tiimsvk/WeatherStation-V-3.0-Esphome/(list of files, cad)

Other CAD files:
weather-station-wiring.dwg
