tiimsvk/WeatherStation-V-3.0-Esphome/(threads)

Thread 2 (2024-10-11):

But where is firmware?

zakdma, 2024-10-11:
I see only a list of the sensors.
But there is no any firmware or construction drawings.

Pank172, 2024-11-08:
Dear, what program did you use to create the weather station electrical diagram file?

Pank172, 2024-11-09:
Dear, I can't compile the file. ESPHome gives me an error log.
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
[logs_weather-station_compile (1).txt](https://github.com/user-attachments/files/17686985/logs_weather-station_compile.1.txt)

tiimsvk, 2024-11-09:
> Dear, what program did you use to create the weather station electrical diagram file?

Autocad

Pank172, 2024-11-09:
I am copying your project to ESPHome, but I cannot compile the firmware. The compilation fails with an error.

tiimsvk, 2024-11-09:
> Dear, I can't compile the file. ESPHome gives me an error log. [logs_weather-station_compile (1).txt](https://github.com/user-attachments/files/17686985/logs_weather-station_compile.1.txt)

oh yes you are right.  When I'm behind the PC, I'll upload the custom components

Pank172, 2024-11-11:
Hello. I still can't compile your yaml file. Can you share your new file?

tiimsvk, 2024-11-12:
I uploaded the file custom_component.zip. It needs to be unpacked into the esphome/custom_component folder.

Pank172, 2024-11-17:
Dear, I apologize. Did you use PlatformIO to compile? Which compiler? I haven't used PlatformIO before.

tiimsvk, 2024-11-18:
I don't understand the question? I compile the code directly in home assistant via esphome with the latest current version and the output is without problems.

Pank172, 2024-11-18:
Do you mount additional libraries directly into ESPHome? I don't know how to do that yet.

Allkorolev, 2024-11-20:
Files in the custom_component archive.zip is broken, please re-upload the archive.

tiimsvk, 2024-11-22:
> Files in the custom_component archive.zip is broken, please re-upload the archive.

I tested the uploaded file. It downloaded and unzipped without any problems.

Allkorolev, 2024-11-24:
> > Files in the custom_component archive.zip is broken, please re-upload the archive.
>
> I tested the uploaded file. It downloaded and unzipped without any problems.

Problem detected with files in the Dallas folder

tiimsvk, 2024-11-26:
I think esphome has already fixed the error in dallas. Try deleting the folder.

Pank172, 2025-04-10:
Sorry. And you don't have a regular circuit. It takes a long time to reverse engineer. It will take some time. I want to model your board in DIP TRACE and then make a printed circuit board.

Pank172, 2025-04-10:
Unfortunately, I don't speak English, my native language is Ukrainian. Therefore, I am forced to use Google Translate.

tiimsvk, 2025-04-11:
> Sorry. And you don't have a regular circuit. It takes a long time to reverse engineer. It will take some time. I want to model your board in DIP TRACE and then make a printed circuit board.

If I make a circuit, for example in EasyEDA, it will probably be only when I’m repairing something on the weather station. Right now, I wouldn’t have time for that. But a PCB board would definitely be great.

Pank172, 2025-04-11:
Good afternoon. I am currently recovering from knee surgery. So I have some free time. I will start designing the PCB. This is not a very fast process. Now I have AutoCAD, PDF and YAML files. I will debug the board in Proteus. This will take some time.
If you have time to make a drawing of the board, it will help in the work. Some clarification is still needed regarding the modules.

Pank172, 2025-04-11:
Could you clarify the information regarding discrete modules? Namely their quantity, because they are not indicated in the description.
This concerns the modules: INA3221, LDO DD2712SA/5V? These modules are drawn several times in your diagram. Therefore, a question arises. As I understood from the diagram, ceramic capacitors are installed to reduce power surges. I also saw several electrolytic capacitors on the diagram.

Pank172, 2025-04-30:
Hello. Finally, I have some free time and I have finished drawing the circuit diagram and prototype of the printed circuit board of your weather station in the DIP TRACE program. I am leaving the files of my work.

[MeteoStation V.3 ESP32_gerber.zip](https://github.com/user-attachments/files/19980454/MeteoStation.V.3.ESP32_gerber.zip)

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

Pank172, 2025-04-30:
DIP TRACE format files

[Метеостанція ESP32.zip](https://github.com/user-attachments/files/19980530/ESP32.zip)

Pank172, 2025-08-05:
Good afternoon. After the latest ESPHome updates, the project cannot be compiled. How did you deal with this? Can you post the updated project data?

tiimsvk, 2025-08-06:
LOG?

tiimsvk, 2025-08-12:
I uploaded a new FW, but be careful, it's a test version because I'm modifying the UV sensor and the pins on the geiger have changed. I'll update next month.
