tiimsvk/WeatherStation-V-3.0-Esphome/wiring weather station.pdf

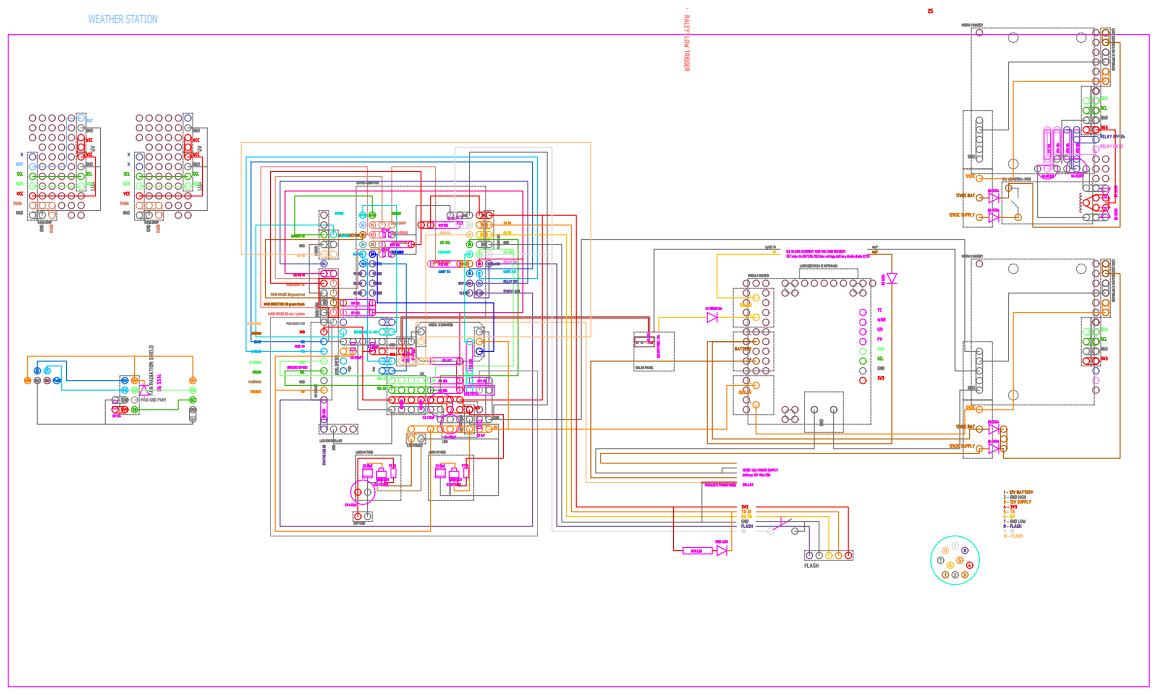
[picture p2: page 1]
WEATHER STATION
