tiimsvk/WeatherStation-V-3.0-Esphome/weather-station.yaml

#-------------------------------------------
# BUG AND REPAIR
#-------------------------------------------
# FIX dependency detceted odstranit z polozky kjtora odkazuje sama na seba (napr vltage bus presunut on value na power)
 # if switch off reducer_consumption_pin bad values adc pins is high (control out voltage when no measure)
# Fix drop 12.5 Voltage charge
# no measure rain when is shutdown change GPIO5 to GPIO12 (GPIO05 strapping pin high at boot)
# "task_wdt: Task watchdog got triggered. The following tasks did not reset the watchdog in time:" FIX: more sensors ... change id name length to short.
# add voltage detektor reset mcu supervisor smd
# aneometer WH-SP-WS01 bad value fixed 2x
# add weather condition whit pressure

#-------------------------------------------
# REVISION
#-------------------------------------------
# 2023.09.3.2.0
 # - replace PM1006 by SPS30
 # - replace MQ2 by MQ9
 # - add step up module DIO6605B
 # - remove spotlight
 # - modification state led

# 2023.10.3.2.1
 # - fix sps30 count/m3

# 2023.11.3.3.0
 # replace BH-1750 lux and UV GYML8511 to LTR-390UV

# 2023.12.3.4
 # add SHT45 prevent bad humidity value
 # remove laching relay and add step down power supply 8V
 # replace new raindrop sensor
 # calibrate pressure +12
 # Wind add cradient https://sk.wikipedia.org/wiki/Beaufortova_stupnica_sily_vetra 
 # Wind speed add max speed per online https://community.home-assistant.io/t/measuring-wind-speed/395693/7
 # wind speed change gpio26 
 # wind heading full round

# 2024.04.3.3.5
 # replace broken dallas sensor on solar panel
 # replace broken dallas sensor battery
 # add 104 capacitor rain gaige and wind speed sensor source: https://www.instructables.com/Solar-Powered-WiFi-Weather-Station-V30/
 # rain gauge change to pullup snesors and fix code whit wakeup reason and sleep
 # remove multiplier uv sesnor filter
 # fixed pm calculate

# 2024.04.3.3.6
 # fixed wind heading mounted to solar panels

# 2024.05.3.3.7
 # Add total rain sensor fixed daily rain.

# 2024.07.3.3.8
 # - change gain X3 to X6 UV LTR390 sensor
 # - fixed bad value dallas battery sensor filter out 85°C broken after esphome update 2024.6

# 2024.07.19.3.3.9
 # bad value aneomter WH-SP-WS01 reference shmu multiple 2x added
 
# 2025.08.12.3.4.0
 # Add UV ADC sensor - GYML8511 replace shield glass to UV Fused Quartz Glass Clear Transparent 
 # Fixed Geiger counter change GPIO04
 # update FW and last esphome
 
#-------------------------------------------
# SUBTITUTIONS - basic definitions and description of the device
#-------------------------------------------
substitutions:
  device_name: ESP-Weatherstation
  friendly_name: weather-station
  created_by: StudioTiiM 2021-2024
  device_description: "A complete battery-powered weather monitoring station"

#-------------------------------------------
# CONECTION OF CABLES
#-------------------------------------------
# RADIATION SHIELD:
  # USB cable:
    # white  : NO 
    # green  : Smoke ADC
    # blue   : GND
    # orange : 5V
  # LAN cable:
    # dark brown  : 5V
    # brig brown  : GND PWM
    # dark blue   : SPS30 SCL
    # brig blue   : SPS30 SDA
    # dark orange : 3.3V
    # brig orange : GND
    # dark green  : MHZ RX
    # brig green  : MHZ TX
    
# SOLAR SHIELD
 # LAN cable:
    # dark brown  : 3V3
    # brig brown  : GND
    # dark blue   : UV ADC
    # brig blue   : not connect
    # dark orange : SCL
    # brig orange : SDA
    # dark green  : not connect
    # brig green  : RAIN ADC

#-------------------------------------------
# POWER CONSUMPTION 
# whit multimeter
#-------------------------------------------
# Power consumption 12V
# First booting MCU + MCU CAM: 300mA
# Booting MCU: 180mA
# Heating sensors: 130mA
# Normal: 40mA
# Deep sleep: 17mA

# Power consumption 5V
# First booting MCU + MCU CAM: 510mA
# Booting MCU after connected to mqtt: 350mA
# Heating sensors: 330mA
# Normal: 270mA
# Deep sleep: 13mA

#-------------------------------------------
# DEFINE PINS AND VARIABILES
# CIRCUIT AND MODULES - basic definitions and description of the device
#-------------------------------------------

# ----- MCU -----
  # Module: ESP32-S + adapter
   # Circuit: Solder on Prototype PCB expansion board ESP32 7x9cm

   # Power Consumption: Peak ~  / Normal wifi:  ~  / Normal: ~  / DeepSleep: ~ 
   # Specification: Chip Family: ESP32 / Chip Model: ESP32S / Chip ID:  / MAC Address:  / Number of Cores:  / CPU Frequency: 240MHz / Ram:  / Flash: 

   # Description pins:
    # PINS ESP32    | FUNCTION     | INPUT | OUTPUT | ADC | PWM | I2C           | SPI  | RESISTOR             | BOOT       | FLASH   | HIGH AT BOOT | BOOT FAILS | NOTES
    # ------------------------------------------------------------------------------------------------------------------------------------------------------------------------------
    # EN            | RESET                                                            | 10.0k PULLUP PCB     |                                     |
    # GPIO0         | STRAPPING    | OK!   | OK!    |     | OK  | OK            |      | 10.0k PULLUP         | PULLUP    | PULLDOWN | PWM          | LOW
    # GPIO01 *      | TX           | OK!*1 | OK     |     | OK  | OK            |      |                      |           |          | HIGH         |            | CONNECTED CH340C
    # GPIO02 *      | STATUS LED   | OK    | OK     |     | OK  | OK            |      | INTERNAL PULLDOWN    | PULLUP    |          | HIGH         |            | LED OR PULLUP 10k
    # GPIO03 *      | RX           | OK    | OK!*1  |     | OK  | OK            |      |                      |           |          | HIGH         |            | CONNECTED CH340C
    # GPIO04        |              | OK    | OK     |     | OK  | OK            |      | INTERNAL PULLDOWN    |           |          |              |
    # GPIO05 *      | STRAPPING    | OK    | OK!    |     | OK  | OK            |      | INTERNAL PULLUP      |           |          | PWM          | LOW
    # GPIO06        | INTERNAL SPI |       |        |     |     |               | CLK  |                      |           |          |              |
    # GPIO07        | INTERNAL SPI |       |        |     |     |               | MISO |                      |           |          |              |
    # GPIO08        | INTERNAL SPI |       |        |     |     |               | MOSI |                      |           |          |              |
    # GPIO09        | INTERNAL SPI |       |        |     |     |               | HD   |                      |           |          | HIGH         |
    # GPIO10        | INTERNAL SPI |       |        |     |     |               | WP   |                      |           |          | HIGH         |
    # GPIO11        | SPI CSC/CMD  |       |        |     |     |               | CS   |                      |           |          | HIGH         |
    # GPIO12        | STRAPPING    | OK!*3 | OK     |     | OK  | OK            |      |                      |           |          | LOW          | HIGH
    # GPIO13        |              | OK    | OK     |     | OK  | OK            |      |                      |           |          |              |
    # GPIO14        |              | OK    | OK     |     | OK  | OK            |      |                      |           |          | PWM          |
    # GPIO15        | STRAPPING    | OK!   | OK!    |     | OK  | OK            |      |                      | PULLDOWN  |          | PWM          | HIGH
    # GPIO16 *      | PSRAM*4      | OK    | OK     |     | OK  | OK            |      |                      |           |          | PWM          |
    # GPIO17 *      | PSRAM*4      | OK    | OK     |     | OK  | OK            |      |                      |           |          | PWM          |
    # GPIO18        |              | OK    | OK     |     | OK  | OK            |      |                      |           |          |              |
    # GPIO19 *      |              | OK    | OK     |     | OK  | OK            |      |                      |           |          |              |

    # GPIO21 *      |              | OK    | OK     |     | OK  | OK            |      |                      |           |          |              |
    # GPIO22 *      |              | OK    | OK     |     | OK  | OK            |      |                      |           |          |              |
    # GPIO23 *      |              | OK    | OK     |     | OK  | OK            |      |                      |           |          |              |
    
    # GPIO25 *      |              | OK    | OK     |     | OK  | OK            |      |                      |           |          |              |
    # GPIO26        |              | OK    | OK     |     | OK  | OK            |      |                      |           |          |              |
    # GPIO27 *      |              | OK    | OK     |     | OK  | OK            |      |                      |           |          |              |

    # GPIO32 *      |              | OK    | OK     |     | OK  | OK            |      |                      |           |          |              |
    # GPIO33 *      |              | OK    | OK     |     | OK  | OK            |      |                      |           |          |              |
    
    # GPIO34 *      |              | OK    |        | OK  |     |               |      |                      |           |          |              |
    # GPIO35 *      |              | OK    |        | OK  |     |               |      |                      |           |          |              |
    # GPIO36 *      | VP *6        | OK*5  |        | OK  |     |               |      |                      |           |          |              |
    # GPIO39 *      | VN *6        | OK*5  |        | OK  |     |               |      |                      |           |          |              |

    # * Connected on this project
    # *1 Disable hardware uart. logger baud_rate: 0
    # *2 recommended I2C
    # *3 May damage flash if low at boot on 1.8V flash chips
    # *4 GPIO 16 & 17 are usually connected to the SPI flash and PSRAM. These do show some activity during boot to detect the presence of PSRAM. For example GPIO 17 may still show some high frequency signal until it is specifically set to a high or low output state. When PSRAM is present, these pins should not be used.
    # *5 GPIO 36 & 39 should not be used for interrupts when also using ADC or WiFi and Bluetooth. These pins are on some boards labelled as: 
    #    The internal Hall sensor in the ESP32 is connected to these two pins.
    #    The Hall Sensor uses channels 0 and 3 of ADC1. Do not configure these channels for use as ADC channels when also reading from the Hall sensor.
    # *6 VP-GPIO36 or VN-GPIO39 high impedance pin
    # GPIO08 and GPIO09 pulldown invalid on boot
    # Current draw 12mA max per GPIO
    # * used on project

 # ----- LEDS -----
  # Modul: Status led
   # Specification: 1x red led
   # Circuit: 10Ω resistor to GPIO
   # Power consumption: 15mA
  status_led: GPIO02
  # Modul: Spotlight not connected
   # Specification: 8x high brightness white leds
   # Circuit: 15Ω resistor to 5V / switching whit NPN Darlington TIP122: Gate - 220Ω GPIO / Gate-Source 10kΩ pulldown
   # Power consumption: 200mA (1pic = 3.3V 25mA)
  # spotlight: GPIO26

 # ----- SMOKE SENSOR -----
 # ----- OLD SENSOR -----
  # Module: MQ-2 Smoke and Gas Sensor
   # Specification: Voltage	5V / Load resistance 20kΩ / Heater resistance	33Ω ± 5% / Heating consumption	<800mw / Sensing Resistance	10 KΩ ~ 60 KΩ / Concentration Range	200 ~ 10000ppm / Preheat Time	Over 24 hour
   # Power consumption: preheat 135mA / standby 
   # Settings: time heating and measure min. 100s
   # RL replace resistor 1kΩ to 2kΩ
   # https://circuitdigest.com/microcontroller-projects/arduino-smoke-detector-on-pcb-using-mq2-gas-sensor
   # First stable value after 90s
  #mq2_pin: GPIO39 # SVN
  # Calibrate:
  # Look datasheet and MQ-2 Gas Sensor Sensitivity Characteristics in Graph:
   # https://thestempedia.com/tutorials/interfacing-mq-2-gas-sensor-with-evive/
   # The graph tells us the concentration of a gas in part per million (ppm) according to the resistance ratio of the sensor (RS/R0).
    # RS is the resistance of the sensor that changes depending on the concentration of gas.
    # R0 is the resistance of the sensor at a known concentration without the presence of other gases, or in the fresh air.

    # RS = (Vin - Vout) / Vout
    
   # After 15 min. ready "MQ2 - R0" value and replace ro value
  #r0_value: "1.565"
   
   # Calculating PPM for a particular gas
   # Analyze the graph:

    # - The scale of the graph is log-log. This means that in a linear scale, the behavior of the gas concentration with respect to the resistance ratio is exponential.
    # - The data for gas concentration only ranges from 200 ppm to 10000 ppm.
    # - Even though the relation between resistance ratio and gas concentration may seem linear, in reality, it is not.

   # First of all, we will treat the lines as if they were linear. This way we can use one formula that linearly relates the ratio and the concentration. 
   # By doing so, we can find the concentration of a gas at any ratio value even outside of the graph’s boundaries.
   # The formula we will be using is the equation for a line, but for a log-log scale. The formula for a line is:
   
   # Math:
    # y: Y value              y = mx + b   
    # x: X value              x = 10 ^ {[log(y) - b] / m}
    # m: Slope of the line    m = log(y/y0) / log(x/x0)
    # b: Y intercept          b = log(y) - m*log(x)

    # For a log-log scale, the formula looks like this:  
    #  log(y) = m*log(x) + b  

    # Measure Smoke and CO calculate a defines in the sensor field

 # ----- NEW SENSOR -----
  # Module: MQ-2 Smoke and Gas Sensor
   # Specification: Voltage	5V / Load resistance 20kΩ / Heater resistance	33Ω ± 5% / Heating consumption	<800mw / Sensing Resistance	10 KΩ ~ 60 KΩ / Concentration Range	200 ~ 10000ppm / Preheat Time	Over 24 hour
   # Power consumption: preheat 135mA / standby 
   # Settings: time heating and measure min. 100s
   # https://circuitdigest.com/microcontroller-projects/arduino-smoke-detector-on-pcb-using-mq2-gas-sensor
   # First stable value after 90s
   # circuit output signal when the sensor is shifted from clean air to carbon monoxide (CO) or CH4, output signal 
   # measurement is made within one or two complete heating period (2.5 minute from high voltage (60s - 5V) to low voltage (90s - 1.4V)).

  mqx_pin: GPIO39 # SVN
  # Calibrate:
  # Look datasheet and MQ-9 Gas Sensor Sensitivity Characteristics in Graph:
   # https://thestempedia.com/tutorials/interfacing-mq-2-gas-sensor-with-evive/
   # The graph tells us the concentration of a gas in part per million (ppm) according to the resistance ratio of the sensor (RS/R0).
    # RS is the resistance of the sensor that changes depending on the concentration of gas.
    # R0 is the resistance of the sensor at a known concentration without the presence of other gases, or in the fresh air.

    # RS = (Vin - Vout) / Vout
    
   # After 15 min. ready "MQ2 - R0" value and replace ro value
  r0_value: "2.732"
   
   # Calculating PPM for a particular gas
   # Analyze the graph:

    # - The scale of the graph is log-log. This means that in a linear scale, the behavior of the gas concentration with respect to the resistance ratio is exponential.
    # - The data for gas concentration only ranges from 200 ppm to 10000 ppm.
    # - Even though the relation between resistance ratio and gas concentration may seem linear, in reality, it is not.

   # First of all, we will treat the lines as if they were linear. This way we can use one formula that linearly relates the ratio and the concentration. 
   # By doing so, we can find the concentration of a gas at any ratio value even outside of the graph’s boundaries.
   # The formula we will be using is the equation for a line, but for a log-log scale. The formula for a line is:
   
   # Math:
    # y: Y value              y = mx + b   
    # x: X value              x = 10 ^ {[log(y) - b] / m}
    # m: Slope of the line    m = log(y/y0) / log(x/x0)
    # b: Y intercept          b = log(y) - m*log(x)

    # For a log-log scale, the formula looks like this:  
    #  log(y) = m*log(x) + b  

    # Measure Smoke and CO calculate a defines in the sensor field

 # ----- REDUCER CONSUMPTION -----
  # Module: LaskaKit Bat-Boost 5V 0.6A Chiptron
   # Chip: DIO6605B
   # Specification: Voltage in 2.7 ~ 4.5V out fixed 5V / current max 0.6A / frequency: 1.2MHz / efficiency 95% / stadby current: 1μA, quiescent current: 55 / protection: overtemperature; Working temperature -40 ~ 85 °C / Logic EN pin: 1.8V
 
  # "Settings: time heating and measure min 3min delay measure (10x per day)"
   # delay measure and minimal consumption battery: MQ9 CO sensor
  reducer_pin: GPIO27

 # ----- TEMPERATURE / HUMIDITY / PRESSURE SENSORS -----
  # Module: Dallas DS18B20
   # Circuit: 4.7k resistor data pin to VCC
   # Power consumption: 50μA
   # Measure: Solar panel and Battery
  dallas_pin: GPIO23
   # UPDATE AFTER BOOT: 1s

  # Module: BME280 - pressure / humidity / temperature (ALT. DHT21 AM2301 750μA; BMP280)
   # Specifications: Voltage: 1.8 ~ 5V / Operational Range: Temperature: -40 ~ +85°C Humidity: 0~100% Pressure: 300~1100 hPa / Accuracy: Temperature: +-1°C Humidity: +-3% Pressure: +-1Pa
   # Circuit: Interface: I2C address: SDO LOW : 0x76 (SDO HIGH: 0x77)
   # Power consumption: 0.4mA
   # UPDATE AFTER BOOT: 1s /if solar panel > 30°C 15s
  
  # Module: SENSIRION SHT45 - humidity / temperature
   # Specifications: Voltage: 1.08 ~ 3.6V / Operational Range: Temperature: -40 ~ +125°C Humidity: 0~100% / Accuracy: Temperature: +-0.1°C Humidity: +-1%
   # Circuit: Interface: I2C address: 0x44
   # Power consumption: Idle: 1.0μA / Measure: 500μA / Heater max 200mW
  
 # ----- FAN RADIATION SHIELD -----
  # Module: 5V Fan 600rpm 50mm (low consumption)
   # Specification: Voltage	5V / Consmption max. 150mA / 600RPM
   # Power consumption: high speed: 150mA / normal speed 100mA / low speed 70mA
   # Circuit: FAN PWM control / switching whit NPN Darlington TIP122: Gate - 220Ω GPIO / Gate-Source 10kΩ pulldown
  fan_pwm_pin:      GPIO19
  temp_compensate: "2.5" # °C if solar panel >23°C and illuminance > 25000lx

 # ----- RAIN SENSORS -----
  # Module: MS-WH-SP-RG rain gauge
   # Specifications: volume 0.2794 l
   # Circuit: VCC-sensor(reed switch)sensor-GPIO-10kΩ pulldown-GND
   # Features additional: wake up pin
  rain_gauge: GPIO25

   # UPDATE AFTER BOOT: 50kΩ = 10s / < 50kΩ = 30s

  # OLD Module: MH-RD Raindrops
   # Circuit: GND and ADC pin
  # NEW Module: HD-83 Raindrops
   # Specifications: Gold sinking process for corrosion resistance / 1MM ultra-fine spacing / Double sided design / Ruler: 56 * 38 * 1.2mm
   # Circuit: GND and ADC pin
   # Consumption: standby 0μA / dry 1.4μA / full wet 10mA
  rain_drop: GPIO34
   # increasing the lifetime of raindrops module
   # Circuit: GPIO-ADCraindrops 10kΩ resistor - GPIO turn on measure ADC pin
  raindrop_switch: GPIO05
   # Variabiles
  resistor_value: "9.9kOhm"   # rain drop resistor
  measure_dry: "10s" # In dry mode
  measure_wet: "30s" # In wet mode / Must be large enough not to damage the tracks prematurely, but small enough to be reactive enough.

 # ----- CO2 SENSOR -----
  # Module: MHZ19 Intelligent Infrared CO2 Module
   # Specifications: Voltage 3.6 ~ 5.5V / Average current < 18 mA /  / Preheat time 3 min / Reponse Time T90 < 60s / Working temperature 0 ~ 50 °C Working humidity 0 ~ 95% RH (No condensation) / Lifespan > 5 years
   # Circuit: Interface UART level 3.3 V
   # Power consumption: preheat 85mA / standby 9mA / pwm heating 90mA (cycle 5-6s 24°C)
   # UPDATE AFTER BOOT: 50s

 # ----- PARTICULATE MATTER SENSOR -----
 # ----- OLD SENSOR -----
  # Module: IKEA VINDRIKTNING Particulate Matter Sensor with PM1006 pm 2.5 (whitout original mcu board)
   # Specifications: Voltage working 5V +-0.2 / Range 0 ~ 1000μg/m³ / Working temperature -20 ~ 75 °C Working humidity 0 ~ 95% RH (No condensation)
   # Circuit: Interface UART level 4.5 V baude rate 9600 connected level-shifter reverse TX RX.
   # Consumption: standby 7.6mA
  # Module: original IKEA VINDRIKTNING Fan 5V
   # Circuit: add protect diode
   # Consumption: 30mA
   # UPDATE AFTER BOOT: 90s + 5x measure filter 5s = 95s

 # ----- NEW SENSOR -----
  # Module: SENSIRION SPS30 Particulate Matter Sensor
   # id: 5224221
   # Serial Number: 'FCBAC51BF0DCABAC'
   # Specifications: Voltage working 4.5 ~ 5.0V / Range 0 ~ 1000μg/m³ / Working temperature -10 ~ 75 °C Working humidity 0 ~ 95% RH (No condensation) / Laser Class 1 660nm /Lifetime 24h/d >10 years
   # Air direction: Fan Out
   # Circuit: I²C address: 
   # Pinout:
    # Left reading (logo green top) 
    # ---------------------------
    # PINS:  5  |  4  |  3  |  2  |  1
    # NAME: GND | SEL | SCL | SDA | VIN
    # ---------------------------
   # PM Number concentration size range: 
    # PM0.5: 0.3 ~ 0.5 μm
    # PM1.0: 0.3 ~ 1.0 μm
    # PM2.5: 0.3 ~ 2.5 μm
    # PM4.0: 0.3 ~ 4.0 μm
    # PM10 : 0.3 ~ 10.0 μm
   # Auto cleaning: 165hours 10s max fan
   # Circuit: I2C address: 0x69 (SEL PIN TO GND)
   # Consumption: sleep: 50µA idle: 360µA measure: 1s 65mA measure fan start: 80mA

   # AQI (Air quality index)
    # AQI       | Level           | PM2.5 (μg/m³) | PM10 (μg/m³)
    # ----------------------------------------------------------
    # 0   - 50  | Good            | 0     - 12    | 0   - 54
    # 51  - 100 | Moderate        | 12.1  - 35.4  | 55  - 154
    # 101 - 150 | Unhealthy for   | 35.5  - 55.4  | 155 - 254
    #             sensitive group 
    # 151 - 200 | Unhealthy       | 55.5  - 150.4 | 255 - 354
    # 201 - 300 | Very unhealthy  | 150.5 - 250.4 | 355 - 424
    #     > 301 | Hazardous       |       > 250.5 |     > 425
    # ----------------------------------------------------------

 # ----- SUN SENSORS -----
 # OLD MODULE
  # Module: BH1750 GY-302 lux meter
   # Specifications: 3V ~ 5V / Range:  1 ~ 65 535 lx
   # Circuit: Interface: I2C address: 0x23
   # Consumption: normal 4.4mA
   # http://wiki.sunfounder.cc/index.php?title=GY-302_BH1750_Digital_Light_Intensity_Module

 # NEW MODULE
  # Module: LTR-390UV Lux and UVA sensor
   # Specifications: Operating voltage: 1.7 ~ 3.6V (max 4.0V) / Operating temperature: - 40 ~ 80 °C / Temperature compesation / Error ALS 25% UV 20%
   # Wavelenght: UVA(400 ~ 320nm) and UVB(320 ~ 290nm) 300-350nm / ALS 500 ~ 620nm
   # Power consumption: Measure: 400μA Standby: 20μA Sleep: 1μA
   # Circuit: I²C address: 0x53
   # Calculate:
    # Lux = ((0.6 * als) / (gain * int)) * wfac
     # als  = ambient light count  On sensor values
     # gain = X6                   Adjusts the sensitivity of the sensor. A larger value means higher sensitivity. See table below for details. 
     # int  = 1                    Is the integration time in 100s of ms and is tied to the resolution
     # wfac = 1.0                  Window correction factor. Use larger values when using under tinted windows. Default is 1.0, must be >= 1.0.
    # UV index = UV / sensitivity * wfac
     # UV = UV sensor count        On sensor values
     # sensitivity = 95            has the value 2300 and is the sensor’s count per UVI https://www.youtube.com/watch?v=VUd6NGAcs4w
     # wfac = 1.0                  Window correction factor. Use larger values when using under tinted windows. Default is 1.0, must be >= 1.0.

   # LUX wiki
    # Illuminance (lux) | Surfaces illuminated by
    # -----------------------------------------------
    # 0.0001 	          | Moonless, overcast night sky (starlight)[5]
    # 0.002 	          | Moonless clear night sky with airglow[5]
    # 0.05–0.3 	          | Full moon on a clear night[6]
    # 3.4 	              | Dark limit of civil twilight under a clear sky[7]
    # 20–50 	          | Public areas with dark surroundings[8]
    # 50 	              | Family living room lights (Australia, 1998)[9]
    # 80 	              | Office building hallway/toilet lighting[10][11]
    # 100 	              | Very dark overcast day[5]
    # 150 	              | Train station platforms[12]
    # 320–500 	          | Office lighting[9][13][14][15]
    # 400 	              | Sunrise or sunset on a clear day.
    # 1000 	              | Overcast day;[5] typical TV studio lighting
    # 10,000–25,000 	  | Full daylight (not direct sun)[5]
    # 32,000–100,000 	  | Direct sunlight

  # Module: GYML8511 UV uv light uva uvb ultraviolet 
   # Specifications: 3V – 5V / Photodiode sensitive to UV-A and UV-B
   # Circuit: ADC
   # Consumption: normal 0.455mA
   # http://wiki.sunfounder.cc/index.php?title=GYML8511_UV_Sensor
  uv_pin: GPIO35 
  
 # ----- WIND SENSORS -----
  # Module: WH-SP-WS01 wind speed anemometer
   # Circuit: 10k resitor GPIO to VCC and GPIO 104 capacitor to GND
  wind_speed_pin: GPIO32
   # Variabiles for calculating wind speed:    
  pulse_revolution: "2" # Number of pulses by revolution 
  radius: "0.09"        # Blade circle radius in meters
  math_pi: "3.1416"     # π
  factor: "1.18"        # Calibration factor compensate friction (you can adjust it)

  # Module: WH-SP-WD wind direction
   # Resistors table: 
   # ANGLE(°)   RESISTOR (kΩ)
   # ---------------------------
   #   0.0      33.00
   #  22.5       6.57
   #  45.0 	    8.20
   #  67.5 	    0.891
   #  90.0 	    1.00
   # 112.5 	    0.688
   # 135.0	    2.20
   # 157.5 	    1.41
   # 180.0 	    3.90
   # 202.5 	    3.14
   # 225.0 	   16.00
   # 247.5 	   14.12
   # 270.0 	  120.00
   # 292.5 	   42.12
   # 315.0 	   64.90
   # 337.5 	   21.88
   # ---------------------------
   # Circuit: 10k resitor GPIO to VCC and GPIO 104 capacitor to GND
  wind_dir_pin: GPIO33

 # ----- RADIATION SENSORS -----
  # Module: Geiger-Counter-RadiationD-v1.1-CAJOE
   # Specifications: Voltage 4.5 ~ 6V / measure range 20mR/h~120mR/h γ X-ray and 100 ～ 1800 degeneracy/min · cm2 soft β For radiation
   # Geiger Muller tube: mounted J321 (360 - 440 V, dimension 10x86mm, lifespan  1 × 109 pulses)
   # Circuit:  on esp32 only VP-GPIO36 or VN-GPIO39 high impedance pin (connected P3 header 5V/GND/VIN(pulse pin))
   # Consumption: 6.66mA (reducer unmount 2x NE555 timer IC1 and U80 header =  speaker and led)
   # https://esphome.io/cookbook/geiger-counter.html
   # https://www.youtube.com/watch?v=K28Az3-gV7E
   
#-------------------------------------------
# Calculate correct value:
# Source: https://sites.google.com/site/diygeigercounter/technical/gm-tubes-supported (method 2)
# Alert value >0.81uSv/h >100cpm
#-------------------------------------------
 # Tube background:
  # SBM-20: 32
  # M4011:  32
  # J305:   25
  # J321:   25
   
  # Gamma Sensitivity Ra226:             44cps/mR/h (SBM-20 = 29, J305 = 44, M4011 = 27             , J321 = 27(chatgpt 45))
  # Gamma Sensitivity Co60:              43cps/mR/h (SBM-20 = 23, J305 = 43, M4011 = 22, LND712 = 18, J321 = 22(chatgpt 50))
  # Gamma Sensitivity CS137:             23cps/mR/h (SBM-20 = 18, J305 = 23, M4011 = ?              , J321 =   (chatgpt 55))
  # Averga isotopes:                     (45+50+55)/3 = 50     CPS / mR/h
  # Multiply counts per second by 60:    50 x 60      = 3000   CPM / mR/h
  # absorption rate for air:             8.77 
  # So finally CPM is divided by 
  # the absorption rate µSv:             3000 / 8.77 = 342.075µSv/h
  # inverse multiply filter lambda:      0.00292µSv
   # https://devices.esphome.io/devices/geiger-counter (65cps/(μR/s)) : factor: 0.00812037037037 and -12 background offset (this is simillar value as above).  

  ra226: "45.0"
  co60:  "50.0"
  cs137: "55.0"

  air_absorp: "8.77"
  # Final formula: 1 / ((((ra226 + co60 + cs137) / 3) * 60) / air_absorption)
  
  geiger_pin: GPIO04 # SVP connected to module to VIN pin
  

 # ----- CHARGING -----
  # Module: Solar panel 18V
   # Specification: 18V 25W   (50W aliexpress :D)
   # Type: Monocrystalline 
   # Solar panel dimension
  width_p:  "0.315" # m
  height_p: "0.480" # m
  
  # Solar Irradiance
  # correction factors:
  # source: https://circuitdigest.com/microcontroller-projects/solar-irradiance-mesurement-meter-using-arduino
  c_lux:     "0.0079" # W/m2 approximation can be made for the Sun wavelength
  c_uvindex: "80.0" # for a direct sunny world
  
  # Temperature reel feels
  # Heat Index > 27°C
   # HI = (−42.379 + 2.04901523 * T + 10.14333127 * RH − 0.22475541 * T * RH − 0.00683783 * T² − 0.05481717 * RH² + 0.00122874 * T² * RH + 0.00085282 * T * RH² − 0.00000199 * T² * RH²) + (Fsun * solar radiation)
  c1: "-42.379"
  c2: "2.04901523"
  c3: "10.14333127"
  c4: "0.22475541"
  c5: "0.00683783"
  c6: "0.05481717"
  c7: "0.00122874"
  c8: "0.00085282"
  c9: "0.00000199"
  
   # T: temperature
   # RH: humidity
  f_sun: "0.02" # coeficient 0.01 -0.03
   
  # Wind Chill < 10°C
   # WCI = (13.12 + 0.6215  * T − 11.37 * v^0.16 + 0.3965 * T * v^0.16) + (Fsun * solar radiation)
  c10: "13.12"
  c11: "0.6215"
  c12: "11.37"
  c13: "0.3965"
  
   # T: temperature
   # v: wind speed
  
  # > 10°C < 27°C
   # Tpocit = T + Cv * v + CRH * RH + Csun * solar radiation
   # T: temperature
   # v: wind speed  je rýchlosť vetra 
  c_v:   "-0.05"   # -0.5 °C pri vetre 10 km/h
  c_rh:  "0.01"   # 0.1 °C za každých 10 % vlhkosti
  c_sun: "0.0003" # 0.03 °C za každých 100 W/m²

  # Australian realfeel
  rain_compensate: "1.0" #°C - rain sensor: 80-0kΩ temperature compensate 0-2.3°C

  # Module: Charger Step Down XL4015 E1 
   # Specification: Voltage in: 4V ~ 37V out: 1.25V ~ 36V 5A efficiency: ~96% (current standby 20mA) / ABOVE INPUT HEADER FIRST current regulator clockwise increase, second voltage regulator clockwise increase
   # Setup: OUT 12.9V/1A (connected protect diode SS34: Voltage Forwarde 0.5V = 12.4V to battery pack)
   
 # ----- BATTERY -----
  # --- old version battery ---
  # Battery: 12V 9Ah 20h max input 13.7V/1.0A (sealed rechargeable acid battery EMOS model OT 9-12)
  # Theoretical battery life: current consumption 300mA / Life: 8 Days

  # --- new version battery ----
  # Battery: 9x 18650 3.7V/2500mAh 
   # Circuit: 3x parallel 3x series 12.4V/7.5Ah out.
   # Protection 1: BMS 3S 20A hw-375 rev2.3
    # Specification: overcharge 4.25V / discharge 2.5V /overcurrent 22A / Working temperature -40- 85 °C
    # Consumption: standby: 20μA
   # Protection 2 (OLD): Polarized power relay latching relay (Signal two coil) ADW1203HL 3V3 16A protect two diode SS110 and 2xNPN BC337 10kΩ pulldown and 100Ω to GPIO
   # Protection 2: set power supply to 8.0V in change to when battery is low.

    # Specification: battery < 9.4V (3.13V one battery) switch to power supply / if current solar > current mcu switch to battery
  #supply_off_pin: GPIO04
  #supply_on_pin: GPIO18
  capacite_battery: "3.6"    # 7.5Ah
  efficiency_charging: "1.3" # efficiency of memory and battery characteristics (20-60%)
   
 # ----- MEASUREMENT OF ELECTRICITY -----
  # Module: INA3221 3CH DC current sensor black board
   # Specification: Voltage in 26V / Voltage operating 2.7 - 5.5V / Working temperature -40 ~ 125 °C / shunt resistor 0.1Ω max current I=V/R; I = 0.1638 mV / 0.1Ω = 1.638 A max
   # Circuit: Interface: I2C address: 0x40
   # Consumption: standby 350μA
  
 # ----- LDO REGULATORS -----
  # Module: step down DD2712SA 5V (alt. OKI-78SR-5/1.5)
   # Specification: Voltage in 6.5 ~ 27V out fixed 5V / current max 2.5A; short 3.5A / frequency: 900kHz / efficiency 75 ~ 92% / stadby current: 250μA / protection: overtemperature; undervoltage; short-circuit; Working temperature -20 ~ 85 °C
  # Module: holtek HT7833 (2x = ESP32cam and ESP32 main mcu)
   # Specification: Voltage in 0-8 out fixed 3.3V 2% / max voltage drop 360mV / current max 0.5A / current standby 0.22mA (datasheet standby current 4μA) / protection: overtemperature; current limiting

#-------------------------------------------
# VARIABILES
#-------------------------------------------
# Update intreval for all sensors
  update_time: 60s 

#-------------------------------------------
# PROTOCOLS
#-------------------------------------------
 # ----- PROTOCOLS PINS -----
  # i2c
  i2c_sda_pin: GPIO21
  i2c_scl_pin: GPIO22
#  i2c_enable_pin: GPIO04
  # uart
  uart_rx_pin: GPIO17
  uart_tx_pin: GPIO16
#  uart2_rx_pin: GPIO14
#  uart2_tx_pin: GPIO13

 # ----- PROTOCOLS SETTINGS -----
uart:
#  - id: uart2 # ikea vindriktining pm1006
#    rx_pin: "$uart2_rx_pin"
#    tx_pin: "$uart2_tx_pin"
#    baud_rate: 9600
  
  - id: uart_typ1 # mhz-19 co2
    rx_pin: "$uart_rx_pin"
    tx_pin: "$uart_tx_pin"
    baud_rate: 9600

i2c:
  sda: "$i2c_sda_pin"
  scl: "$i2c_scl_pin"
  scan: True
  frequency: 100kHz

one_wire:
  - platform: gpio
    pin: 
      number: "$dallas_pin"
      mode:
        input: true
        pullup: true
    #update_interval: $update_time

#-------------------------------------------
# CUSTOM COMPONENT
# Custom SPS30 component
# https://github.com/esphome/feature-requests/issues/2385
#-------------------------------------------
external_components:
  - source: 
      type: local
      path: custom_component
    components:
      - sps30
      - sht4x

#-------------------------------------------
# ESP - MAIN SETTINGS
#-------------------------------------------
esphome:
  name: weather-station
  project:
    name: "studiotiim.weather_station"
    version: 2025.08.3.4.0
  platformio_options:
    board_build.f_cpu: 160000000L # set cpu clock 160mhz
  on_boot:
#    - priority: 1200
#      then:
        #- lambda: |-
        #    pinMode(18, OUTPUT);
        #    digitalWrite(18, HIGH);
        #    delay(300);
#        - switch.turn_on: i2c_enable
#        - delay: 300ms

    #- priority: 600
    #  then:
    #    lambda: |-
    #      Wire.begin();
    #      delay(100);

    - priority: 900
      then:
        # Find how to esp wake up (deep sleep cycle or rtc pin wake up)
        # Rain-gauge add one measuring when is wake up whit gauge pin
        #- lambda: |-
        #    id(wakeup_pin) = ((log(esp_sleep_get_ext1_wakeup_status()))/log(2));;
        #    esp_sleep_pd_config(ESP_PD_DOMAIN_RTC_PERIPH, ESP_PD_OPTION_ON); //INTERNAL PD
        # wakeup reaseon: 
        # 0 = reset
        # 3 = pin wakeup
        # 4 = sleep reset
        - lambda: |-
            int wakeup_reason = esp_sleep_get_wakeup_cause();
            ESP_LOGD("boot", "wakeup_reason: %d", wakeup_reason);
            if (wakeup_reason == 3) {   // EXT1
              double gpio_num = (log(esp_sleep_get_ext1_wakeup_status()))/log(2);
              ESP_LOGD("boot", "gpio_num: %f", gpio_num);
            }
            id(wakeup_pin) = wakeup_reason;
        - delay: 100ms
        - component.update: wakeup_temp
        

    - priority: 600
      then:
        - lambda: id(sleep_prevent).publish_state(false); # on boot send template state false

    - priority: -200 # when everithing should by inicialized
      then:
        - switch.turn_on: res_bias # turn on resistance on raindrop sensor
        # - if: 
            # condition:
            #   mqtt.connected: # send online state when mqtt is connected to wifi and server
            #then:
        - text_sensor.template.publish:  # Send online state when wifi is connected 
            id: online_s
            state: "Online"
    - priority: -400  # delay so that the device is not overloaded at startup
      then:
        - delay: 2s
        - switch.turn_on: switch_reducer # turn on measure sps30 gaiger and mq2 sensor less load when booting
        - text_sensor.template.publish: # second send online 
            id: online_s
            state: "Online"

  on_shutdown: # send offline state when mcu power off or go to deep sleep
    - then:
        - text_sensor.template.publish:
            id: online_s
            state: "Offline"
        - logger.log: Shutdown Called
        #- switch.turn_off: i2c_enable
        # reduce leaking current when enable deep sleep
        #- lambda: |-
        #    esp_sleep_pd_config(ESP_PD_DOMAIN_RTC_FAST_MEM, ESP_PD_OPTION_OFF);
        #    esp_sleep_pd_config(ESP_PD_DOMAIN_RTC_SLOW_MEM, ESP_PD_OPTION_OFF);
        #    esp_sleep_pd_config(ESP_PD_DOMAIN_RTC_PERIPH, ESP_PD_OPTION_OFF); 
        #    // This config is large power consumption +80uA
        #    //gpio_deep_sleep_hold_en();
        #    //adc_power_release();
        #    //gpio_hold_en((gpio_num_t) 12);
        #    // i2c enable high impedancy
        #    //pinMode(21, INPUT);
        #    //pinMode(22, INPUT);

    - priority: -801.0 # tested more settings the server does not always receive the value
      then:
        - component.update: up_time
        - text_sensor.template.publish:
            id: online_s
            state: "Offline"
        - switch.turn_off: res_bias

esp32:
  board: esp32dev
  framework:
    type: arduino

logger:
  level: DEBUG
  logs:
    # Hidden warning: 
    # [00:00:00][W][component:204]: Component xxxxxx took a long time for an operation (x.xx s).
    # [00:00:00][W][component:205]: Components should block for at most 20-30ms.
    # Source: https://github.com/esphome/issues/issues/4717
    component: ERROR

#-------------------------------------------
# MQTT
#-------------------------------------------
mqtt:
  broker: '192.168.31.212'
  username: !secret mqtt_username
  password: !secret mqtt_password
  discovery: true
  # add discovery_unique_id_generator fix this problem "Platform mqtt does not generate unique IDs"
  # source: https://github.com/esphome/issues/issues/4840
  discovery_unique_id_generator: mac

  # online first message
  birth_message:
    topic: $device_name/status_on
    payload: online
  # drop connected message
  will_message:
    topic: $device_name/status_unaiavalable
    payload: unavailable
  # offline last message
  shutdown_message:
    topic: $device_name/status_off
    payload: offline
  # OTA message
  on_message:
    - topic: $device_name/ota_mode
      payload: 'ON'
      then:
        - deep_sleep.prevent: sleep_component
        - logger.log: "OTA BLOCKING DEEP SLEEP"

    - topic: $device_name/ota_mode
      payload: 'OFF'
      then:
        - logger.log: "OTA FINISHED BACK TO DEEP SLEEP ALLOW"
        - deep_sleep.allow: sleep_component

ota:
  platform: esphome
  password: !secret ota_password

wifi:
  manual_ip:
    static_ip: 192.168.31.59
    gateway: 192.168.31.1
    subnet: 255.255.255.0
  #enable_on_boot: False # future features
  ssid: !secret wifi_ssid
  password: !secret wifi_password

  ap:
    ssid: "$device_name Hotspot"
    password: "passweatherstation"

captive_portal:

#-------------------------------------------
# DEEP SLEEP COMPONENT
#-------------------------------------------
deep_sleep:
  run_duration: 100s # all sensor send state (in time 100s)
  sleep_duration: 13min
  #sleep_duration: 30s # testing time
  id: sleep_component
  esp32_ext1_wakeup: 
    pins: 
      number: $rain_gauge
      allow_other_uses: true
    mode: ALL_LOW 
  # Only pins 0, 2, 4, 12, 13, 14, 15, 25, 26, 27, 32, 33, 34, 35, 36, 37, 38, 39 support wakeup.
  #wakeup_pin_mode: KEEP_AWAKE # when is high no deepsleep enter

#-------------------------------------------
# SCRIPTS
#-------------------------------------------
script:
#-------------------------------------------
# Deep sleep script allow
# prevent deep sleep when raindrop detected
# if raindrop sensor is wet, it's probably raining, a rain gauge can record the amount of water
# after raindrop sensor dry go to deep sleep after 100s
#-------------------------------------------
  - id: sleep_script 
    mode: single
    then:
      if:
        condition:
          binary_sensor.is_off: sleep_prevent
        then:
          - logger.log: 
              format: "ENTER DEEPSLEEP + 85s"
              level: warn
          - delay: 85s
          - text_sensor.template.publish:
              id: online_s
              state: "Offline"
          - component.update: up_time
          - logger.log: 
              format: "BEGIN DEEPSLEEP + 5s"
              level: warn
          - delay: 5s
          - if:
              condition:
                - sensor.in_range:
                    id: bat_volt
                    below: 10.0
              then:
                - lambda: id(sleep_component).set_sleep_duration(1680000);
              else:
                - lambda: id(sleep_component).set_sleep_duration(600000);
          - deep_sleep.enter: sleep_component

#-------------------------------------------
# GLOBALS
#-------------------------------------------
globals:
#-------------------------------------------
# RESTORE VALUE BME280 module
#-------------------------------------------
  - id: temp_g
    type: float
    restore_value: yes
    initial_value: '20.0'

  - id: humi_g
    type: float
    restore_value: yes
    initial_value: '50.0'

  - id: pres_g
    type: float
    restore_value: yes
    initial_value: '1000'

#-------------------------------------------
# RESTORE VALUE power state (battery/power supply switch)
#-------------------------------------------
#  - id: power_g
#    type: bool
#    restore_value: yes
#    initial_value: "false"

#-------------------------------------------
# RESTORE VALUE esp_sleep_get_ext1_wakeup_status
# Rain-gauge add one measuring when is wake up whit gauge pin
#-------------------------------------------
  - id: wakeup_pin
    type: uint64_t
    restore_value: no
    initial_value: '0'

#-------------------------------------------
# STATUS LED
# orange led - when online led is light
#-------------------------------------------
status_led:
  pin:
    number: ${status_led}
    inverted: True
    ignore_strapping_warning: true

#-------------------------------------------
# TEXT SENSORS
#-------------------------------------------
text_sensor:
#-------------------------------------------
# Beaufort scale wind
#-------------------------------------------
  - platform: template
    id: wind_scale
    name: "Wind - Scale"
    lambda: |-
      return {"Loading"};
    icon: "mdi:power-standby"
    update_interval: never

#-------------------------------------------
# Online state mcu
# bug no send online or offline does always state 
#-------------------------------------------
  - platform: template
    id: online_s
    name: "Status"
    lambda: |-
      return {"Loading"};
    icon: "mdi:power-standby"
    update_interval: never
    entity_category: diagnostic

#-------------------------------------------
# Rain drop text sensor 
# ... on boot loading
#-------------------------------------------
  - platform: template
    id: rain_s
    name: "Rain - Fall"
    lambda: |-
      return {"Loading"};
    icon: "mdi:waterfall"
    update_interval: never

#-------------------------------------------
# Wind direction text sensor
# ... on boot loading
#-------------------------------------------
  - platform: template
    name: "Wind - Direction"
    id: wind_dir
    lambda: |-
      return {"Loading"};
    update_interval: never
    icon: mdi:weather-windy

#-------------------------------------------
# Battery Condition
# ... on boot loading
#-------------------------------------------
  - platform: template
    name: "Battery - Condition"
    id: text_batcond
    lambda: |-
      return {"Loading"};
    update_interval: never
    icon: mdi:battery-heart-outline
    entity_category: diagnostic

#-------------------------------------------
# SENSORS
#-------------------------------------------
sensor:
  - platform: uptime
    name: Uptime
    accuracy_decimals: 1
    unit_of_measurement: s
    update_interval: never
    id: up_time

#-------------------------------------------
# Internal board ESP32 Temperature 
#-------------------------------------------
  - platform: internal_temperature
    #id: temp
    name: "Temperature - MCU"
    update_interval: "$update_time"

#-------------------------------------------
# Wifi signal component
#-------------------------------------------
  - platform: wifi_signal
    name: "Signal"
    update_interval: "$update_time"

#-------------------------------------------
# UV and Ambient Light
# LTR-390
#-------------------------------------------
  - platform:                   ltr390
    ambient_light:             
      name:                    "Illuminance - ALS"
      unit_of_measurement:     "count"
      accuracy_decimals:        0
    light:                     
      name:                    "Illuminance"
      accuracy_decimals:        0
      id:                       lux_sensor
      filters:                 
        - offset:              -1.0
        - lambda:              'return max((float)0.0, x);'
    uv:                        
      name:                    "UV - Count 2"
      unit_of_measurement:     "count"
    uv_index:                  
      name:                    "UV - Index 2"
      accuracy_decimals:        2
      id:                       uv_sensor
      filters:
        - median:
            window_size:   5
            send_every:    5
            send_first_at: 5
            
        #- multiply: 1.32
        #- calibrate_linear:
        #    method: exact
        #    datapoints:
        #      - 0.0 -> 0.0
        #      - 3.5 -> 1.0
        #      - 4.5 -> 2.0
        #      - 7.0 -> 8.0
    update_interval: 2s
    window_correction_factor: 1.3
    gain:
      ambient_light: X1
      uv:            X9 # see note in esphome docs
    resolution:
      ambient_light: 20
      uv:            13 # see note in esphome docs


#-------------------------------------------
# UV index - GUVA-S12SD
#-------------------------------------------
  - platform: adc
    id: adcuv
    pin: "$uv_pin"
    attenuation: 12dB
    name: "UV - Intensity"
   #update_interval: "$update_time" # bug ready below
    update_interval: 2s # test value
   #update_interval: never
    #filters:
     #- lambda: 'return max((float)0.99, x);' # original in datasheet minimum 0.99
     # - lambda: 'return max((float)1.03, x);'  # measure more time min. 0.99-1.03
     # - lambda: 'return min((float)2.8, x);'
    #unit_of_measurement: 'mW/cm²'
    #on_value:
    #  then:
    #    component.update: uv_index
    icon: 'mdi:sunglasses'

  #- platform: template
  #  name: "UV - Index"
  #  id: uv_index
  #  lambda: |-
  #     return ((id(adcuv).state - 1.03) * (15.0 - 0.0) / (2.8 - 1.0) + 0.0);
  #     // return ((id(adcuv).state - 0.99) * (15.0 - 0.0) / (2.8 - 0.99) + 0.0);
  # # corecct factor +0.3
  #  update_interval: "never"
  #  unit_of_measurement: "UV index"
  #  icon: 'mdi:sunglasses'
  #  filters:
  #    - calibrate_polynomial:
  #       degree: 3
  #       datapoints:
  #        # calibrate whit hydrometeorology institute still measure and calibrate sensor not final 
  #        - 0.0 -> 0.0
  #        - 0.1 -> 0.0
  #        - 0.2 -> 0.0
  #        - 1.4 -> 5.0
  #        - 3.5 -> 8.0
  #        - 10.0 -> 14.5
  #        - 15.0 -> 15.0
  #    - lambda: 'return max((float)0, x);'

#-------------------------------------------
# LUX sensor - BH1750
#-------------------------------------------
#  - platform: bh1750
#    name: "${friendly_name} LUX"
#    address: 0x23
#    accuracy_decimals: 0
#    update_interval: "$update_time"

#-------------------------------------------
# Smoke detector - MQ-2 Smoke and Gas Sensor
#-------------------------------------------
  - platform: adc
    name: "MQx - RAW"
    pin: "$mqx_pin"
    update_interval: never
    attenuation: 12db
    accuracy_decimals: 3
    id: mqx_raw
    icon: "mdi:smoke"
    filters:
      - median:
          window_size: 4
          send_every: 4
          send_first_at: 4
      - lambda: return x * (4.97 / 3.3); // convert adc voltage 5V to 3.3V
    entity_category: diagnostic
    on_value:
      then:
        - component.update: mqx_ro
#        - component.update: mq2_smoke
        - component.update: mqx_co

#-------------------------------------------
# MQ2 - RO 
# read when first started and preheated for 24 hours, read the value after 15 minutes
#-------------------------------------------
  - platform: template
    name: "MQx - R0"
    id: mqx_ro
    accuracy_decimals: 4
    update_interval: never
    icon: "mdi:smoke"
    unit_of_measurement: "R0"
    entity_category: diagnostic
    lambda: |-
      const float air_rs_ro = 9.8;                                                // From the graph, we can see that the resistance ratio in fresh air is a constant: RS / R0 = 9.8
      const float vdc = 4.97;                                                     // measure with multimeter 4.97V (LaskaKit Bat-Boost 5V 0.6A Chiptron)
      //const float vdc = id(volt_out).state;                                     // 5.0V or input sensor vdc to esp32
      // RO= ((5.0 - adc                ) / adc                ) / 9.8            // formula in excel
      return ((vdc - id(mqx_raw).state) / id(mqx_raw).state) / air_rs_ro;         // 
    
    # MQ-2
    # In the table given below, you can find the value of m and b for different gases.
    # --------------------------------------------------------------
    # Gas       Value   Value     Value         m             b
    #           at 200  at 10000  at 5000  
    # --------------------------------------------------------------
    # H2        2.1     0.33      0.460    -0.473054470  1.412572126
    # LPG       1.6     0.27      0.370    -0.454838059  1.250634060
    # Methane   3.0     0.70      0.940    -0.372003751  1.349158571
    # CO        5.1     1.35      1.800    -0.339756680  1.512022272
    # Alcohol   2.8     0.65      0.850    -0.373311285  1.310286169
    # Smoke     3.4     0.60      0.950    -0.443402570  1.617856412
    # Propane   1.7     0.28      0.385    -0.461038681  1.290828982
    # --------------------------------------------------------------

#-------------------------------------------
# MQ2 - Smoke
#-------------------------------------------
#  - platform: template
#    name: "${friendly_name} MQ2 - Smoke"
#    id: mq2_smoke
#    unit_of_measurement: ppm
#    accuracy_decimals: 0
#    update_interval: never
#    device_class: carbon_dioxide
#    icon: "mdi:smoke"
#    lambda: |-      
#      const float x_left = 200.0;    // straight line for smoke x min value
#      const float y_up = 3.4;        // straight line for smoke y max value
#      const float x_right = 10000.0; // straight line for smoke x max value
#      const float y_down = 0.6;      // straight line for smoke y min value
      
#      const float x_middle = 5000.0; // straight line for smoke middle point
#      const float y_middle = 0.95;   // straight line for smoke middle point
      
#      const float vdc = id(voltage_out).state - 0.1;         // 5.0V or input sensor vdc to esp32
       
#      //=   POWER(10; (LOG10 (((5.0 - ADC                ) / ADC                ) / 0,4)- (LOG10 (0,95)     - (LOG10 (0,6    / 3,4 ) / LOG10 (10000   / 200   )) * LOG10 (5000    ))) / (LOG10 (0,6    / 3,4 ) / LOG10 (10000   / 200   )))      formula in excel
#      return powf(10, (log10f(((vdc - id(mq2_raw).state) / id(mq2_raw).state) / ${r0_value}) - (log10f(y_middle) - (log10f(y_down / y_up) / log10f(x_right / x_left)) * log10f(x_middle))) / (log10f(y_down / y_up) / log10f(x_right / x_left)));
#    filters:
#      - lambda: 'return min((float)10000.0, x);'
      
#-------------------------------------------
# MQ2 - CO
#-------------------------------------------
  - platform: template
    name: "CO"
    id: mqx_co
    unit_of_measurement: ppm
    accuracy_decimals: 0
    update_interval: never
    device_class: carbon_dioxide
    icon: "mdi:smoke"
    lambda: |-
      const float x_left = 200.0;    // straight line for co x min value
      const float x_middle = 500.0;  // straight line for co middle point
      const float x_right = 1000.0;  // straight line for co x max value

      const float y_up = 1.7;        // straight line for co y max value
      const float y_middle = 1.1;    // straight line for co middle point
      const float y_down = 0.8;      // straight line for co y min value

      
      const float vdc = id(volt_out).state - 0.1;         // 5.0V or input sensor vdc to esp32

      return powf(10, (log10f(((vdc - id(mqx_raw).state) / id(mqx_raw).state) / ${r0_value}) - (log10f(y_middle) - (log10f(y_down / y_up) / log10f(x_right / x_left)) * log10f(x_middle))) / (log10f(y_down / y_up) / log10f(x_right / x_left)));
    filters:
      - lambda: 'return min((float)1000.0, x);'

#-------------------------------------------
# DALLAS temperature sensor - DS18B20 
# connected 4.7k to VCC 
#-------------------------------------------
# Temperature solar panel
  - platform: dallas_temp
    address: 0x695d65a308646128
    name: "Temperature - Solar"
    id: temp_sol
    entity_category: diagnostic
    unit_of_measurement: "°C"
    icon: mdi:thermometer
    on_value:
    # update bme280 sensor condition fan
      - if: 
          condition: 
            sensor.in_range:
              id: temp_sol
              above: 25.0
          then: 
            - fan.turn_on:
                id: shield_fan
                speed: 95 # + 100mA 20s
            - delay: 20s
            - fan.turn_off:
                id: shield_fan
            - component.update: temp_t
            - component.update: pres_t
            - component.update: humi_t
          else:
            - component.update: temp_t
            - component.update: pres_t
            - component.update: humi_t
            
# Temperature battery
  - platform: dallas_temp
    address: 0x5df941a308646128
    name: "Temperature - Battery"
    id: temp_bat
    unit_of_measurement: "°C"
    icon: mdi:thermometer
    entity_category: diagnostic
    filters:
      filter_out: 85
        
#-------------------------------------------
# Temperature humidity pressure sensor - BME280
#-------------------------------------------
  - platform: bme280_i2c
    temperature:
      id: temp_s
     # oversampling: 8x
      on_value:
        then:
          - component.update: altitude
          - component.update: dewpoint
          - component.update: temp_reelfeel
          - component.update: temp_reelfeel2

          - globals.set:
              id: temp_g
              value: !lambda 'return x;'
      internal: True
    pressure:
      id: pres_s
      internal: True
      filters:
        offset: 12.0
      on_value:
        then:
          - globals.set:
              id: pres_g
              value: !lambda 'return x;'
    humidity:
      name: "Humidity - BME"
      id: humi_bme
      internal: true
      accuracy_decimals: 0
      on_value:
        then:
          - if: 
              condition: 
                sensor.in_range: 
                  id: humi_bme
                  above: 90.0
              then: 
                - switch.turn_on: heater_sht
      #filters:
        #offset: 12.0 # correct whit hydro institute 
    address: 0x76
    update_interval: 15s

#-------------------------------------------
# Temperature humidity sensor - SHT45
# whit heater fix humidity
#-------------------------------------------
  - platform: sht4x
    temperature:
      name: "Temperature - SHT"
      accuracy_decimals: 1
    humidity:
      name: "Humidity"
      id: humi_s
      internal: True
      icon: mdi:water-percent
      accuracy_decimals: 0
      on_value:
        then:
          - globals.set:
              id: humi_g
              value: !lambda 'return x;'
    heater_max_duty: 0.0
    heater_power: High
    heater_time: Long
    update_interval: 15s
    precision: High 
    id: sht45

#-------------------------------------------
# Template - Temperature humidity pressure
# component update manually control whit fan and temperature solar panel
#-------------------------------------------
  - platform: template
    name: "Temperature"
    id: temp_t
    update_interval: never
    unit_of_measurement: "°C"
    icon: "mdi:thermometer"
    lambda: |-
      // Skontrolujeme, či sú všetky potrebné senzory dostupné
      if (isnan(id(temp_sol).state) || isnan(id(lux_sensor).state)) {
      // Ak niektorý senzor nie je dostupný, vráti sa hodnota temp_t bez kompenzácie
        return id(temp_g);
      }
      float kompenzacia = 0.0;
      
      if (id(lux_sensor).state >= 10000) {
        // Lineárna interpolácia od 23 °C do 35 °C s kompenzáciou od 0 do -2
        if (id(temp_sol).state > 23.0) {
          kompenzacia = (id(temp_sol).state - 23.0) * (-${temp_compensate} / (35.0 - 23.0));
          if (kompenzacia < -${temp_compensate}) {
            kompenzacia = -${temp_compensate}; // Maximálna kompenzácia -2 °C
          }
        }
      }
      
      // Dodatočná kompenzácia, ak je teplota 10 °C, pripočíta sa 1 °C
      float vysledna_teplota = id(temp_g) + kompenzacia;
      if (id(temp_s).state <= 10.0) {
        vysledna_teplota += 1.0;
      }
      
      return vysledna_teplota;

    #lambda: "return id(temp_g);"
    device_class: temperature
    state_class: measurement
    
#-------------------------------------------
# Template - Altitude
# FIX STANDARD_SEA_LEVEL_PRESSURE
#-------------------------------------------
  - platform: template
    name: "Altitude"
    id: altitude
    lambda: |-
      const float STANDARD_SEA_LEVEL_PRESSURE = 1013.25; //in hPa, see note in http://www.esphome.io/
      return ((id(temp_s).state + 273.15) / 0.0065) *
        (powf((STANDARD_SEA_LEVEL_PRESSURE / id(pres_s).state), 0.190234) - 1); // in meter
    update_interval: never
    icon: 'mdi:image-filter-hdr'
    unit_of_measurement: 'm'

  - platform: template
    name: "Pressure - Equi. Sea"
    lambda: |-
      const float STANDARD_ALTITUDE = 0.6; // in meters, see note
      return id(temp_s).state / powf(1 - ((0.0065 * STANDARD_ALTITUDE) /
        (id(temp_s).state + (0.0065 * STANDARD_ALTITUDE) + 273.15)), 5.257); // in hPa
    update_interval: 15s
    unit_of_measurement: 'hPa'
    icon: mdi:waves-arrow-up

#-------------------------------------------
# Template - Absolute humidity
#-------------------------------------------
  - platform: absolute_humidity
    #id: absol_humi
    name: "Humidity - Absolute"
    temperature: temp_s
    humidity: humi_s
    #equation: Wobus

#-------------------------------------------
# Template - Dew point
#-------------------------------------------
  - platform: template
    id: dewpoint
    name: "Temperature - Dew Point"
    device_class: temperature
    lambda: |-
      return (243.5*(log(id(humi_s).state/100)+((17.67*id(temp_s).state)/
      (243.5+id(temp_s).state)))/(17.67-log(id(humi_s).state/100)-
      ((17.67*id(temp_s).state)/(243.5+id(temp_s).state))));
    unit_of_measurement: °C
    icon: 'mdi:thermometer-alert'
    update_interval: never
#    lambda: |-
#      return (id(temperature_sensor).state - (100 - id(humidity_sensor).state) / 5);  

   
  - platform: template
    name: "Pressure"
    id: pres_t
    update_interval: never
    unit_of_measurement: "hPa"
    icon: "mdi:gauge"
    lambda: "return id(pres_g);"
    accuracy_decimals: 0
    device_class: pressure
    
  - platform: template
    name: "Humidity"
    id: humi_t
    update_interval: never
    unit_of_measurement: "%"
    icon: "mdi:thermometer"
    lambda: "return id(humi_g);"
    device_class: humidity
  # Temperature reel feels
  - platform: template
    name: "Temperature - Real Feel"
    id: temp_reelfeel
    update_interval: never
    unit_of_measurement: "°C"
    icon: "mdi:thermometer"
    device_class: temperature
    lambda: |-
      // Heat Index > 27°C
      if (id(temp_t).state > 27)                                     { return (${c1} + ${c2} * id(temp_t).state + ${c3} * id(humi_t).state - ${c4} * id(temp_t).state * id(humi_t).state - ${c5} * pow(id(temp_t).state, 2) - ${c6} * pow(id(humi_t).state, 2) + ${c7} * pow(id(temp_t).state, 2) * id(humi_t).state + ${c8} * id(temp_t).state * pow(id(humi_t).state, 2) - ${c9} * pow(id(temp_t).state, 2) * pow(id(humi_t).state, 2)) + (${f_sun} * id(solar_radia).state); }
      // Wind Chill < 10°C
      else if (id(temp_t).state < 10 && id(wind_average).state >= 5) { return (${c10} + ${c11}  * id(temp_t).state - ${c12} * pow(id(wind_average).state, 0.16) + ${c13} * id(temp_t).state * pow(id(wind_average).state, 0.16)) + (${f_sun} * id(solar_radia).state) * 0.1;}
      // > 10°C < 27°C
      else                                                           { return id(temp_t).state + ${c_v} * id(wind_average).state + ${c_rh} * id(humi_t).state + ${c_sun} * id(solar_radia).state ;}
  
  # Temperature reel feels
  - platform: template
    name: "Temperature - Real Feel Australia"
    id: temp_reelfeel2
    update_interval: never
    unit_of_measurement: "°C"
    icon: "mdi:thermometer"
    device_class: temperature
    lambda: |-
      float temp = isnan(id(temp_t).state) ? 20.0 : id(temp_t).state;
      float humi = isnan(id(humi_t).state) ? 50.0 : id(humi_t).state;
      float wind = isnan(id(wind_average).state) ? 0.0 : id(wind_average).state;
      float solar = isnan(id(solar_radia).state) ? 0.0 : id(solar_radia).state;
      float rain = isnan(id(rain_res).state) ? 0.0 : id(rain_res).state;

      float e = (humi / 100.0) * 6.105 * exp((17.27 * temp) / (temp + 237.7));
      float feel_temp = temp + (0.348 * e) - (0.70 * (wind / 3.6)) - 4.25 + 
                        0.7 * ((solar * 0.07) / ((wind / 3.6) + 10)) - 
                        ((- $rain_compensate / 80 ) * rain + $rain_compensate);
      return isnan(feel_temp) ? 0.0 : feel_temp;  // Ak je výsledok stále nan, nastaví 0.0
    state_class: measurement
      
#-------------------------------------------
# Wind Speed - WH-SP-WS01
#
# Specification for calculating speed
# Number of pulses by revolution            pulse_revolution = 2 pulses (sensor has 1 magnet 2 pulses. but 1Hz give good values)
# Blade radius to center                    radius           = 0.09 m
# Circumference in meter                    circ_m           = radius * 2 * π = 0.09 * 2 * 3.14 = 0.5652 m
# Rotation per second                       rotation         = pulse / pulse_revolution / 60 = 1 / 2 / 60 = 0.00833
# Calibration factor compensate friction    factor           = 1.18 (you can adjust it)
# Meter per second                          mps              = factor * circ_m * rotation = 1.18 * 0.5652 * 0.00833 = 0.00556 m/s
# kilometer per hour                        kmh              = mps * 3.6 = 0.02 km/h
# 
# datasheet 2.376km/h per second 
#-------------------------------------------
  - platform: pulse_meter
    pin: 
      number: "$wind_speed_pin"
      mode: INPUT
    id: windspeed_raw
    name: "Wind - Speed Raw"
    icon: 'mdi:weather-windy'
    #count_mode:
    #  rising_edge: DISABLE
    #  falling_edge: INCREMENT
    #internal_filter: 70us #50 
    internal_filter: 150us #50 
    timeout: 60s
    accuracy_decimals: 0
    filters:
      - lambda: 'return min((float)3000.0, x);' # fix add capacitor 104
      - lambda: return x * ((${factor} * (${radius} * 2 * ${math_pi}) * 1 / ${pulse_revolution} / 60) * 3.6 ) * 2; 
    on_value:
      then:
        - component.update: wind_average
        - sensor.template.publish:
            id: windspeed_max
            state: !lambda |-
              static float max_value = 0.0;
              if (x > max_value) { 
                max_value = x;
              }
              return id(windspeed_max).state = max_value;
        - if: 
            condition: 
              sensor.in_range: 
                id: windspeed_raw
                above: 1.0
            then: 
              component.update: windspeed
            else:
              # fix value 0 send (window size 10)
              - sensor.template.publish:
                  id: windspeed
                  state: !lambda 'return 0.0;'
              - sensor.template.publish:
                  id: windspeed
                  state: !lambda 'return 0.0;'
              - sensor.template.publish:
                  id: windspeed
                  state: !lambda 'return 0.0;'
              - sensor.template.publish:
                  id: windspeed
                  state: !lambda 'return 0.0;' 
              - sensor.template.publish:
                  id: windspeed
                  state: !lambda 'return 0.0;'
              - sensor.template.publish:
                  id: windspeed
                  state: !lambda 'return 0.0;' 
              - sensor.template.publish:
                  id: windspeed
                  state: !lambda 'return 0.0;'
              - sensor.template.publish:
                  id: windspeed
                  state: !lambda 'return 0.0;'
              - sensor.template.publish:
                  id: windspeed
                  state: !lambda 'return 0.0;' 
              - sensor.template.publish:
                  id: windspeed
                  state: !lambda 'return 0.0;'
              - sensor.template.publish:
                  id: windspeed
                  state: !lambda 'return 0.0;'
    # device_class: wind_speed
    
  - platform: template
    name: "Wind Speed Average"
    id: wind_average 
    device_class: wind_speed
    state_class: measurement
    lambda: return id(windspeed_raw).state;
    unit_of_measurement: 'km/h'
    update_interval: never
    filters:
      - throttle_average: 90s

#-------------------------------------------
# Wind speed Max
#-------------------------------------------
  - platform: template
    id: windspeed_max
    name: "Wind - Speed Gust"
    update_interval: never
    device_class: wind_speed
    state_class: measurement
    unit_of_measurement: 'km/h'
    icon: mdi:weather-windy
    filters:
      - filter_out: 60.1
      - filter_out: 60.0
      
#-------------------------------------------
# Beaufort scale
# Source: https://en.wikipedia.org/wiki/Beaufort_scale
#-------------------------------------------
  - platform: template
    id: wind_number
    name: "Wind - Beaufort"
    update_interval: never
    unit_of_measurement: 'scale'
    icon: mdi:weather-windy
    accuracy_decimals: 0

  - platform: template
    id: windspeed
    name: "Wind - Speed"
    lambda: return id(windspeed_raw).state;
    update_interval: never
    device_class: wind_speed
    unit_of_measurement: 'km/h'
    filters:
      # multiply: 0.02
      #- skip_initial: 2
      - sliding_window_moving_average:
          window_size: 10
          send_every: 10
          send_first_at: 10
      #- lambda: !lambda |-
      #    ///int wind_int = int(id().state);
      #    if (id(windspeed_raw) == 0.0) return 0.0;
      #    return x;
    on_value:
    #Calm
      - if:
          condition:
            sensor.in_range:
              id: windspeed
              below: 2.0
          then:
            - text_sensor.template.publish:
                id: wind_scale
                state: "Calm"
            - sensor.template.publish:
                id: wind_number
                state: 0.0
      - if:
          condition:
            sensor.in_range:
              id: windspeed
              above: 2.0
              below: 5.0
          then:
            - text_sensor.template.publish:
                id: wind_scale
                state: "Light Air"
            - sensor.template.publish:
                id: wind_number
                state: 2.0
      - if:
          condition:
            sensor.in_range:
              id: windspeed
              above: 5.0
              below: 11.0
          then:
            - text_sensor.template.publish:
                id: wind_scale
                state: "Light Breeze"
            - sensor.template.publish:
                id: wind_number
                state: 3.0
      - if:
          condition:
            sensor.in_range:
              id: windspeed
              above: 11.0
              below: 19.0
          then:
            - text_sensor.template.publish:
                id: wind_scale
                state: "Gentle Breeze"
            - sensor.template.publish:
                id: wind_number
                state: 4.0
      - if:
          condition:
            sensor.in_range:
              id: windspeed
              above: 19.0
              below: 28.0
          then:
            - text_sensor.template.publish:
                id: wind_scale
                state: "Moderate Breeze"
            - sensor.template.publish:
                id: wind_number
                state: 5.0
      - if:
          condition:
            sensor.in_range:
              id: windspeed
              above: 28.0
              below: 38.0
          then:
            - text_sensor.template.publish:
                id: wind_scale
                state: "Fresh Breeze"
            - sensor.template.publish:
                id: wind_number
                state: 6.0
      - if:
          condition:
            sensor.in_range:
              id: windspeed
              above: 38.0
              below: 49.0
          then:
            - text_sensor.template.publish:
                id: wind_scale
                state: "Strong Breeze"
            - sensor.template.publish:
                id: wind_number
                state: 7.0
      - if:
          condition:
            sensor.in_range:
              id: windspeed
              above: 49.0
              below: 61.0
          then:
            - text_sensor.template.publish:
                id: wind_scale
                state: "Near Gale"
            - sensor.template.publish:
                id: wind_number
                state: 8.0
      - if:
          condition:
            sensor.in_range:
              id: windspeed
              above: 61.0
              below: 74.0
          then:
            - text_sensor.template.publish:
                id: wind_scale
                state: "Fresh Gale"
            - sensor.template.publish:
                id: wind_number
                state: 9.0
      - if:
          condition:
            sensor.in_range:
              id: windspeed
              above: 74.0
              below: 88.0
          then:
            - text_sensor.template.publish:
                id: wind_scale
                state: "Severe Gale"
            - sensor.template.publish:
                id: wind_number
                state: 10.0
      - if:
          condition:
            sensor.in_range:
              id: windspeed
              above: 88.0
              below: 102.0
          then:
            - text_sensor.template.publish:
                id: wind_scale
                state: "Storm"
            - sensor.template.publish:
                id: wind_number
                state: 11.0
      - if:
          condition:
            sensor.in_range:
              id: windspeed
              above: 102.0
              below: 117.0
          then:
            - text_sensor.template.publish:
                id: wind_scale
                state: "Violent Storm"
            - sensor.template.publish:
                id: wind_number
                state: 12.0
      - if:
          condition:
            sensor.in_range:
              id: windspeed
              above: 117.0
          then:
            - text_sensor.template.publish:
                id: wind_scale
                state: "Hurricane"
            - sensor.template.publish:
                id: wind_number
                state: 13.0

#-------------------------------------------
# Wind direction - WH-SP-WD
#-------------------------------------------
  - platform: adc
    id: winddir
    pin: "$wind_dir_pin"
    attenuation: 12db
    internal: true
    accuracy_decimals: 2
    filters:
    #  - multiply: 0.846153 # 3.9 -> 3.3V
      # - median:
      #     window_size: 10
      #     send_every: 10
      #     send_first_at: 10
      throttle_average: 60s 
    icon: mdi:weather-windy
    update_interval: 1s
    on_value:
    #JUH
      - if:
          condition:
            sensor.in_range:
              id: winddir
              above: 2.20
              below: 2.70
          then:
            - text_sensor.template.publish:
                id: wind_dir
                state: "JV"
            - sensor.template.publish:
                id: wind_head
                state: 180
    #JUHOZÁPAD
      - if:
          condition:
            sensor.in_range:
              id: winddir
              above: 1.30
              below: 1.50
          then:
            - text_sensor.template.publish:
                id: wind_dir
                state: "J"
            - sensor.template.publish:
                id: wind_head
                state: 225
    #ZÁPAD
      - if:
          condition:
            sensor.in_range:
              id: winddir
              above: 0.15
              below: 0.45
          then:
            - text_sensor.template.publish:
                id: wind_dir
                state: "JZ"
            - sensor.template.publish:
                id: wind_head
                state: 270
    #SEVEROZÁPAD
      - if:
          condition:
            sensor.in_range:
              id: winddir
              above: 0.50
              below: 0.75
          then:
            - text_sensor.template.publish:
                id: wind_dir
                state: "Z"
            - sensor.template.publish:
                id: wind_head
                state: 315
    #SEVER
      - if:
          condition:
            sensor.in_range:
              id: winddir
              above: 0.85
              below: 1.05
          then:
            - text_sensor.template.publish:
                id: wind_dir
                state: "SZ"
            - sensor.template.publish:
                id: wind_head
                state: 0
    #SEVEROVÝCHOD
      - if:
          condition:
            sensor.in_range:
              id: winddir
              above: 1.80
              below: 2.10
          then:
            - text_sensor.template.publish:
                id: wind_dir
                state: "S"
            - sensor.template.publish:
                id: wind_head
                state: 45
    #VÝCHOD
      - if:
          condition:
            sensor.in_range:
              id: winddir
              above: 2.95
              below: 3.15
          then:
            - text_sensor.template.publish:
                id: wind_dir
                state: "SV"
            - sensor.template.publish:
                id: wind_head
                state: 90
    #JUHOVÝCHOD 
      - if:
          condition:
            sensor.in_range:
              id: winddir
              above: 2.75
              below: 2.90
          then:
            - text_sensor.template.publish:
                id: wind_dir
                state: "V"
            - sensor.template.publish:
                id: wind_head
                state: 135

  - platform: template
    name: "Wind - Heading"
    id: wind_head
    unit_of_measurement: "°"
    icon: mdi:weather-windy
    accuracy_decimals: 0

#-------------------------------------------
# CO2 sensor - MHZ19
#-------------------------------------------
  - platform: mhz19
    co2:
      name: "CO2"
    temperature:
      name: "Temperature - CO2"
      accuracy_decimals: 1
    update_interval: "$update_time"
    # abc mhz calibration switch turn on/off automatic baseline calibration 
    automatic_baseline_calibration: True
    uart_id: uart_typ1
    id: mhz19_co2

#-------------------------------------------
# Electricity component - INA3221 3CH DC current sensor
#-------------------------------------------
  - platform: ina3221
    address: 0x40
    id: ina3221_component
    # solar panel
    channel_1:
      shunt_resistance: 0.1 ohm
      current:
        name: "Current - Solar"
        accuracy_decimals: 0
        id: solar_cur
        entity_category: diagnostic
        filters:
          - multiply: 1000 # convert A to mA 
          - median:
              window_size: 3
              send_every: 3
              send_first_at: 3
        unit_of_measurement: mA
      power:
        name: "Power - Solar"
        accuracy_decimals: 2
        id: solar_pow
        entity_category: diagnostic
      bus_voltage:
        name: "Voltage - Solar"
        entity_category: diagnostic
      #shunt_voltage:
      #  name: "${friendly_name} Shunt Voltage Solar"
      #  internal: true
    # battery charge
    channel_2:
      shunt_resistance: 0.1 ohm
      current:
        name: "Current - Battery"
        id: bat_cur
        entity_category: diagnostic
        filters:
          - multiply: 1000 # convert A to mA 
          - median:
              window_size: 3
              send_every: 3
              send_first_at: 3
        unit_of_measurement: mA
        accuracy_decimals: 0
        on_value:
          then:
            - component.update: cur_value
      power:
        name: "Power - Battery"
        entity_category: diagnostic
      bus_voltage:
        name: "Voltage - Battery"
        id: bat_volt
        entity_category: diagnostic
        filters:
          - quantile:
              window_size: 5
              send_every: 5
              send_first_at: 5
              quantile: .5
        #battery condition script
        on_value:
          then:
            - component.update: bat
            - if:
                condition:
                  sensor.in_range:
                    id: temp_bat
                    above: 35.0
                then:
                  - text_sensor.template.publish:
                      id: text_batcond
                      state: "WARNING OVERHEAT!"
                else:
                  - if:
                      condition:
                        lambda: "return (id(solar_cur).state) > (id(mcu_cur).state);"
                      then:
                        - if: 
                            condition:
                              - sensor.in_range:
                                  id: bat_volt
                                  below: 10.2
                            then:
                              - text_sensor.template.publish:
                                  id: text_batcond
                                  state: "Charging / LOW"
                            else:
                              - text_sensor.template.publish:
                                  id: text_batcond
                                  state: "Charging"
                      else:
                            - if:
                                condition:
                                  - sensor.in_range:
                                      id: bat_volt
                                      below: 4.0
                                then:
                                  - text_sensor.template.publish:
                                      id: text_batcond
                                      state: "No Battery/Supply"
                            - if:
                                condition:
                                  - sensor.in_range:
                                      id: bat_volt
                                      below: 8.4
                                      above: 4.0
                                then:
                                  - text_sensor.template.publish:
                                      id: text_batcond
                                      state: "Critical Low/Supply"
                            - if:
                                condition:
                                  - sensor.in_range:
                                      id: bat_volt
                                      below: 10.2
                                      above: 8.4
                                then:
                                  - text_sensor.template.publish:
                                      id: text_batcond
                                      state: "Low"
                            - if:
                                condition:
                                  - sensor.in_range:
                                      id: bat_volt
                                      below: 12.4
                                      above: 10.2
                                then:
                                  - text_sensor.template.publish:
                                      id: text_batcond
                                      state: "Normal"
                            - if:
                                condition:
                                  - sensor.in_range:
                                      id: bat_volt
                                      above: 12.4
                                then:
                                  - text_sensor.template.publish:
                                      id: text_batcond
                                      state: "Full"

      #shunt_voltage:
      #  #name: "${friendly_name} Shunt Voltage Battery"
      #  internal: true
    #out
    channel_3:
      shunt_resistance: 0.1 ohm
      current:
        name: "Current - Out"
        accuracy_decimals: 0
        id: cur_out
        entity_category: diagnostic
        on_value:
          then:
            component.update: mcu_cur
        filters:
          - multiply: 1000
          - median:
              window_size: 3
              send_every: 3
              send_first_at: 3
        unit_of_measurement: mA
      power:
        name: "Power - Out"
        accuracy_decimals: 2
        entity_category: diagnostic
      bus_voltage:
        name: "Voltage - Out"
        entity_category: diagnostic
        id: volt_out
      #shunt_voltage:
      #  #name: "${friendly_name} Shunt Voltage Out"
      #  internal: true
    update_interval: "5s"

#-------------------------------------------
# Template sensor - Current Out state
# Bug whitout this sensor: ERROR Circular dependency detected!
#-------------------------------------------
  - platform: template
    name: "Current - Mcu"
    id: mcu_cur
    lambda: "return id(cur_out).state;"
    update_interval: never
    entity_category: diagnostic
    internal: True

#-------------------------------------------
# Total energy
#-------------------------------------------
  - platform: total_daily_energy
    name: "Solar - Energy"
    power_id: solar_pow
    icon: "mdi:solar-power"
    on_value:
      then:
        - component.update: solar_radia
    accuracy_decimals: 2
    state_class: total_increasing
    device_class: energy

#-------------------------------------------
# Solar radiation component
#
# watt*(1m2/(a*b))*24
# 1 kW/m2 × (24 h/day) = (24 kWh/m2)/day
#-------------------------------------------

  - platform: template
    name: "Solar - Irradiance"
    icon: "mdi:solar-power"
    unit_of_measurement: "W/m²"
    id: solar_radia
    device_class: irradiance
    lambda: |-
      return (id(lux_sensor).state * $c_lux + ((id(uv_sensor).state / 10) * $c_uvindex));
    update_interval: never
    accuracy_decimals: 0

#-------------------------------------------
# Battery - template sensor units %
#-------------------------------------------
  - platform: template
    name: "Battery"
    lambda: |-
      return (id(bat_volt).state);
    filters:
      - calibrate_linear:
          - 12.54 -> 100
          - 9.9 -> 0
      - lambda: 'return min((float)100.0, x);'
      - lambda: 'return max((float)0.0, x);'
    accuracy_decimals: 0
    update_interval: never
    entity_category: diagnostic
    unit_of_measurement: "%"
    device_class: battery
    id: bat

#-------------------------------------------
# Battery - charging time hours
# Time charging= ((Capacity battery[Ah] - (Capacity battery[Ah] / 100[%] * Battery capacite[%])) * Efficiency characteristics) / Current charging[A]
#-------------------------------------------
  # Prevent + charging value
  - platform: template
    #name: "${friendly_name} Charging Value"
    internal: True
    lambda: |-
      return (id(bat_cur).state);
    filters:
    #  - lambda: 'return max((float)0.0, x);'
      - multiply: 0.001
      - quantile:
          window_size: 5
          send_every: 5
          send_first_at: 5
          quantile: .5

    accuracy_decimals: 3
    update_interval: never
    entity_category: diagnostic
    unit_of_measurement: "A"
    device_class: battery
    id: cur_value
    on_value:
      if:
        condition:
          sensor.in_range:
            id: bat_cur
            below: 0.0
        # CHARGING
        then:
          - sensor.template.publish:
              id: bat_charg_time
              state: !lambda "return ((${capacite_battery} - (${capacite_battery} / 100 * id(bat).state)) * ${efficiency_charging}) / id(cur_value).state;"
        # DISCHARGING
        else:
          - sensor.template.publish:
              id: bat_charg_time
              state: !lambda "return ((${capacite_battery} / 100 * id(bat).state)) / (id(cur_value).state * 1.2);"

  - platform: template
    name: "Battery - Dis/Charging Time"
    lambda: "return 0.0;"
    accuracy_decimals: 1
    update_interval: never
    entity_category: diagnostic
    unit_of_measurement: "h"
    #device_class: battery
    id: bat_charg_time
    icon: mdi:battery-clock
    filters:
      # filter range for a clear graph statistic
      - lambda: 'return min((float)120.0, x);'
      - lambda: 'return max((float)-120.0, x);'

#-------------------------------------------
# IKEA VINDRIKTNING Particulate Matter Sensor with PM1006 inside
# pm 2.5
#-------------------------------------------
#  - platform: pm1006
#    id: particulate_matter
#    pm_2_5:
#      name: "${friendly_name} PM2.5"
#      filters:
#      - median:
#          window_size: 4
#          send_every: 4
#          send_first_at: 4
#    update_interval: "never"
#    uart_id: uart2

#-------------------------------------------
# SPS30 Particulate Matter Sensor
#-------------------------------------------
  - platform: sps30
    id: my_sps30
    pm_1_0:
      name: "PM - Weight 1.0"
      accuracy_decimals: 1
      id: "sps_pm1"
    pm_2_5:
      name: "PM - Weight 2.5"
      id: "sps_pm2_5"
      accuracy_decimals: 1
      filters:
        - lambda: "return (x - id(sps_pm1).state);"
    pm_4_0:
      name: "PM - Weight 4.0"
      id: "sps_pm4"
      accuracy_decimals: 1
      filters:
        - lambda: |-
            if (x - id(sps_pm1).state  - id(sps_pm2_5).state < 0) { return 0                                             ;}
            else                                                  { return (x - id(sps_pm1).state  - id(sps_pm2_5).state);}
    pm_10_0:
      name: "PM - Weight 10.0"
      #id: "sps_pm10"
      accuracy_decimals: 1
      filters:
        - lambda: |-
            float pm_weight = (x - id(sps_pm1).state  - id(sps_pm2_5).state - id(sps_pm4).state);
            if (pm_weight < 0) return 0; 
            else return pm_weight;

    pmc_0_5:
      name: "PM - Count 0.5"
      id: "sps_pmc0_5"
      unit_of_measurement: count/cm³
      accuracy_decimals: 0
    pmc_1_0:
      name: "PM - Count 1.0"
      id: "sps_pmc1"
      unit_of_measurement: count/cm³
      accuracy_decimals: 0
      filters:
        - lambda: "return (x - id(sps_pmc0_5).state);"
    pmc_2_5:
      name: "PM - Count 2.5"
      id: "sps_pmc2_5"
      unit_of_measurement: count/cm³
      accuracy_decimals: 0
      filters:
        - lambda: "return (x - id(sps_pmc1).state - id(sps_pmc0_5).state);"
    pmc_4_0:
      name: "PM - Count 4.0"
      id: "sps_pmc4"
      unit_of_measurement: count/cm³
      filters:
        - lambda: "return (x - id(sps_pmc2_5).state - id(sps_pmc1).state - id(sps_pmc0_5).state);"
    pmc_10_0:
      name: "PM - Count 10.0"
      #id: "sps_pmc10"
      unit_of_measurement: count/cm³
      accuracy_decimals: 0
      filters:
        - lambda: "return (x - id(sps_pmc4).state - id(sps_pmc2_5).state - id(sps_pmc1).state - id(sps_pmc0_5).state);"
    pm_size:
      name: "PM - Typical Size"
      #id: "pm_size"
    address: 0x69
    update_interval: "$update_time"

#-------------------------------------------
# Pulse counter - Geiger module 
# OLD:
# Correct value:
# >0.81 >100cpm alert
# calculate tube m4011, mounted J321 
# Gamma Sensitivity Ra226 (cps/mR/hr) 27 (SBM-20 tube = 29)
# Gamma Sensitivity Co60 (cps/mR/hr) 22
# (27+22)/2=24.5
# Multiply counts per second by 60 to get CPM: 24.5 x 60 = 1470 CPM
# absorption rate to be use is 8.77 which I understand is for air
# So finally the 1530 CPM is divided by the absorption rate of 8.77 to get ratio between CPM and uSv: 1470 / 8.77 = 167.617
# inverse 0.00596598639455782312925170068027
# https://sites.google.com/site/diygeigercounter/technical/gm-tubes-supported (method 2)
#-------------------------------------------
  # CPM
  - platform: pulse_counter
    pin: 
      number: "$geiger_pin"
      #allow_other_uses: true
    id: geigercount
    # internal: true
    name: "${friendly_name} Radiation Count Raw"
    #unit_of_measurement: 'CPM'
    #accuracy_decimals: 0
    filters:
      - lambda: return x * (1.0/60.0);
    count_mode:
      rising_edge: DISABLE
      falling_edge: INCREMENT
    icon: mdi:radioactive
    update_interval: $update_time
    #update_interval: 1ms
    internal_filter: 250us #190us
    use_pcnt: False

    total:
      unit_of_measurement: 'CPM'
      id: geigercount_total
      internal: True
            
  # CPM - template 
  # only send measure time
  - platform: template
    name: "Radiation - Count"
    id: radiation_cpm
    icon: mdi:radioactive
    unit_of_measurement: 'cpm'
    accuracy_decimals: 0
    update_interval: never
    lambda: "return (id (geigercount_total).state);"
    filters:
      - filter_out: nan
      #- offset: "-15.0"
      - lambda: 'return max((float)0.0, x);'
    on_value:
      then:
        - sensor.template.publish:
            id: radiation_pow
            state: !lambda "return ((1 / (((($ra226 + $co60 + $cs137) / 3) * 60) / $air_absorp)) * id(radiation_cpm).state);"

  # µSv/h
  - platform: template
    name: "Radiation - Power"
    id: radiation_pow
    icon: mdi:radioactive
    unit_of_measurement: 'µSv/h'
    accuracy_decimals: 3
    filters:
      filter_out: nan
    on_value_range:
      - above: 0.8
        then:
          - binary_sensor.template.publish:
              id:    sleep_prevent_radiation
              state: true
      - below: 0.8
        then:
          - binary_sensor.template.publish:
              id:    sleep_prevent_radiation
              state: false

#-------------------------------------------
# Rain drops sensor MH-RD Raindrops
# Dry     > 49000 Ω
# Wet     < 49000 Ω
# Raining < 4000  Ω
#-------------------------------------------
  # ADC
  - platform: adc
    id: rain_adc
    pin: "$rain_drop"
    name: "Rain - Drop Raw"
    attenuation: 12db
    internal: true
    # It is important to have a low update interval so that
    # the measurement has time to be done correctly during
    # the activation of the voltage AND taking into account the median filter
    update_interval: never
    filters:
      - median:
          window_size: 4
          send_every: 4
          send_first_at: 4

  # RESISTANCE
  - platform: resistance
    sensor: rain_adc
    id: rain_res
    name: "Rain - Drop"
    configuration: DOWNSTREAM
    resistor: $resistor_value
    reference_voltage: 3.3V
    icon: "mdi:waterfall"
    unit_of_measurement: 'kΩ'
    filters:
      # No value lower than 1 000ohm
      - lambda: 'return max((float)1000, x);'
      # No value greater than 80 000ohm
      - lambda: 'return min((float)80000, x);'
      - multiply: 0.001 # convert ohm to kiloohm
    accuracy_decimals: 1
    on_value:
      - if:
          condition:
            sensor.in_range:
              id: rain_res
              above: 49.000
          then:
            - text_sensor.template.publish:
                id: rain_s
                state: "Dry"
            #- delay: 5s
            - if:
                condition:
                  and:
                    - binary_sensor.is_off: sleep_prevent
                    - binary_sensor.is_off: sleep_prevent_rain
                    - binary_sensor.is_off: sleep_prevent_radiation
                then:
                  - script.execute: sleep_script
                else:
                  - if:
                      condition:
                        or:
                          - binary_sensor.is_on: sleep_prevent
                          - binary_sensor.is_on: sleep_prevent_rain
                          - binary_sensor.is_on: sleep_prevent_radiation
                      then:
                        - script.stop: sleep_script
                        - deep_sleep.prevent: sleep_component
                        - logger.log: 
                            format: "RAINGAUGE OR PRESS PREVENT DEEPSLEEP"
                            level: warn
          else:
            - if:
                condition:
                  sensor.in_range:
                    id: rain_res
                    above: 4.000
                    below: 49.000
                then:
                  - text_sensor.template.publish:
                      id: rain_s
                      state: "Wet"
                else:
                  - text_sensor.template.publish:
                      id: rain_s
                      state: "Raining"
            - if:
                condition:
                  or:
                    #- sensor.in_range:
                    #    id: rain_res
                    #    below: 49.000
                    - binary_sensor.is_on: sleep_prevent_rain
                    - binary_sensor.is_on: sleep_prevent
                then:
                  - script.stop: sleep_script
                  - deep_sleep.prevent: sleep_component
                  - logger.log: 
                      format: "WET MEASURE PREVENT DEEPSLEEP"
                      level: warn
            - wait_until:
                condition:
                  sensor.in_range:
                    id: rain_res
                    below: 49.000
                timeout: 180s
            - script.execute: sleep_script


#-------------------------------------------
# Rain gauge sensor - MS-WH-SP-RG
#-------------------------------------------
  - platform: pulse_counter
    pin:
      number: "$rain_gauge"
      mode: INPUT_PULLUP
      allow_other_uses: true
    unit_of_measurement: 'mm/min'
    name: "Rain - raw"
    #icon: 'mdi:weather-rainy'
    id: raingauge_raw
    #internal: True
    count_mode:
      rising_edge: DISABLE
      falling_edge: INCREMENT
    # use_pcnt: False
    # internal_filter: 13us
    #update_interval: 10s
    filters:
    # volume one pulse 0.2794 l
      - multiply: 0.2794 # pulses x 0.2794mm for default 60s
    accuracy_decimals: 2
    on_value:
      - if:
          condition:
            sensor.in_range:
                id: raingauge_raw
                above: 0.2
          then:
            - sensor.template.publish:
                id: rain_gauge
                state: !lambda "return id(raingauge_raw).state;"
          else:
            - sensor.template.publish:
                id: rain_gauge
                state: 0.0

  - platform: template
    name: "Wake Up Pin"
    id: wakeup_temp
    accuracy_decimals: 0
    entity_category: diagnostic
    #internal: True
    lambda: |-
      return (id(wakeup_pin));
    update_interval: never
    on_value:
      then:
        - if:
            condition:
               - lambda: "return id(wakeup_pin) == 3;"
              #sensor.in_range:
              #  id: wakeup_temp
               # below: 30
            then:
              - lambda: id(sleep_prevent_rain).publish_state(true);
              - sensor.template.publish:
                  id: rain_gauge
                  state: 0.2794
              - delay: 100ms
              - lambda: id(sleep_prevent_rain).publish_state(false);
            else:
              lambda: id(sleep_prevent_rain).publish_state(false);
        
  - platform: template
    name: "Rain"
    id: rain_gauge
    icon: 'mdi:weather-rainy'
    filters:
      lambda: if (isnan(x)) {  return 0.0; } return x;
    unit_of_measurement: 'mm/min'
    accuracy_decimals: 2
    update_interval: never

#  - platform: total_daily_energy
#    name: 'Total Daily Rain'
#    power_id: rain_gauge
#    unit_of_measurement: 'mm'
#    state_class: total_increasing
    #device_class: energy
#    accuracy_decimals: 3
#    filters:
#      lambda: return 1/0.2794;  # cca 3.5 pulses per mm

    #expire_after: 60s
    
# Can not be when deep sleep enable
#  - platform: total_daily_energy
#    name: "${friendly_name} Rainfall Daily"
#    power_id: rain_gauge
#    unit_of_measurement: 'mm'
#    icon: 'mdi:weather-rainy'
#    # x60 To convert to aggregated rain amount
#    filters:
#      - multiply: 60
#    accuracy_decimals: 2
#    device_class: distance

#-------------------------------------------
# BINARY SENSORS
#-------------------------------------------
binary_sensor:
#-------------------------------------------
# Power supply template
#-------------------------------------------
 ##  - platform: template
 ##    name: "${friendly_name} Power Supply"
 ##    id: power_state
 ##    icon: mdi:power-plug
  ##   entity_category: diagnostic
 ##    lambda: "return id(power_g);"

#-------------------------------------------
# Raingauge - Prevent Deep Sleep
#-------------------------------------------
  - platform: gpio
    pin:
      number: "$rain_gauge"
      allow_other_uses: true
    name: "Deep Sleep - GPIO"
    internal: True
    #filters:
    #  delayed_off: 30s
    id: sleep_prevent_raingpio
    icon: mdi:power-sleep
    entity_category: diagnostic
    on_state:
      then:
        - script.stop: sleep_script
        - lambda: id(sleep_prevent_rain).publish_state(true);
        - deep_sleep.prevent: sleep_component
        - logger.log: 
            format: "RAINGAUGE PREVENT DEEPSLEEP"
            level: warn
        - delay: 100ms
        - lambda: id(sleep_prevent_rain).publish_state(false);

  #-------------------------------------------
  # Deep Sleep RAIN binary template 
  #-------------------------------------------
  - platform: template
    filters:
      - delayed_off: 30s
    name: "Deep Sleep - Prevent Rain"
    id: sleep_prevent_rain
    icon: mdi:power-sleep
    trigger_on_initial_state: False
    entity_category: diagnostic
  #-------------------------------------------
  # Deep Sleep RADIATION binary template 
  #-------------------------------------------
  - platform: template
    filters:
      - delayed_off: 30s
    name: "Deep Sleep - Prevent Radiation"
    id: sleep_prevent_radiation
    icon: mdi:power-sleep
    trigger_on_initial_state: False
    entity_category: diagnostic

  #-------------------------------------------
  # Deep Sleep binary template 
  #-------------------------------------------
  - platform: template
    name: "Deep Sleep - Prevent"
    id: sleep_prevent
    icon: mdi:power-sleep
    trigger_on_initial_state: true
    entity_category: diagnostic

#-------------------------------------------
# SWITCHES
#-------------------------------------------
switch:
#-------------------------------------------
# Switch template: Heater sensor SHT45
#-------------------------------------------
  - platform: template
    name: "Temperature - Heater"
    id: heater_sht
    optimistic: True
    on_turn_on:
      then:
        - lambda: id(sht45).heater_on();
    on_turn_off:
      then:
        - lambda: id(sht45).heater_off();
    entity_category: config

#-------------------------------------------
# Switch template: Measure sensor SPS30
#-------------------------------------------
  - platform: template
    name: "PM - Measure"
    id: measure_sps30
    optimistic: True
    on_turn_off:
      then:
        - lambda: id(my_sps30).stop_measure();
    on_turn_on:
      then:
        - lambda: id(my_sps30).start_measure();
    entity_category: config
    icon: mdi:restart-off
    restore_mode: ALWAYS_ON

  #- platform: gpio
  #  pin: $i2c_enable_pin
      #drive_strength: 40mA

  #  name: "${friendly_name} I2C supply"
  #  id: i2c_enable
   # restore_mode: ALWAYS_ON
 
#-------------------------------------------
# Power Relay switch
# Polarized power relay latching relay
#-------------------------------------------
#  - platform: gpio
#    pin: $supply_on_pin #25
#    name: "${friendly_name} Power Supply ON"
#    on_turn_on:
#      - delay: 150ms
#      - switch.turn_off: supply_on
#      - globals.set:
#          id: power_g
#          value: "true"
#    id: supply_on
#    entity_category: config
#    icon: mdi:power-plug
#    restore_mode: ALWAYS_OFF

#  - platform: gpio
#    pin: $supply_off_pin #04
#    name: "${friendly_name} Power Supply OFF"
#    on_turn_on:
#      - delay: 150ms
#      - switch.turn_off: supply_off
#      - globals.set:
#          id: power_g
#          value: "false"
#    id: supply_off
#    entity_category: config
#    icon: mdi:power-plug-off
#    restore_mode: ALWAYS_OFF

#-------------------------------------------
# Switch - Rain drop - low destruction sensor
#-------------------------------------------
  - platform: gpio
    id: res_bias
    name: "Rain - Drop Measure "
    icon: "mdi:waterfall"
    entity_category: config
    pin:
      number: "$raindrop_switch"
      mode: OUTPUT
      drive_strength: 5mA
      ignore_strapping_warning: true
    on_turn_on:
      then:
        - component.update: rain_adc
        - delay: 100ms
        - component.update: rain_adc
        - delay: 100ms
        - component.update: rain_adc
        - delay: 100ms
        - component.update: rain_adc
        - delay: 100ms
        - component.update: rain_adc
        - switch.turn_off: res_bias

#-------------------------------------------
# CO2 sensor - MHZ19 - Auto Calibrate Baseline
#-------------------------------------------
  - platform: template
    name: "MH-Z19 - Calibrate"
    icon: mdi:molecule-co2
    optimistic: true
    on_turn_on:
      mhz19.abc_enable: mhz19_co2
    on_turn_off:
      mhz19.abc_disable: mhz19_co2
    entity_category: config

#-------------------------------------------
# Repeat measure reducer power consumption 5V modules
# Smoke, PM2.5 + internal fan
# Wiring whit IRFZ44N power mofset
#-------------------------------------------
  - platform: gpio
    name: "GAIGER MQ - Measure"
    icon: mdi:air-filter
    restore_mode: ALWAYS_OFF
    pin:
      number: "$reducer_pin"
    id: switch_reducer
    on_turn_on:
      - then:
          - delay: 500ms
          # EDIT
          - pulse_counter.set_total_pulses:
              id: geigercount
              value: "0"

          - delay: 75s # wait time to heat mq2 and fan replaces the air
          # update component 5 time (window size 5)
          #- wifi.enable:
          - component.update: mqx_raw
          #- component.update: particulate_matter
          - component.update: radiation_cpm
          - delay: 1s
          - component.update: mqx_raw
          #- component.update: particulate_matter

          #  EDIT
          - component.update: geigercount
          - pulse_counter.set_total_pulses:
              id: geigercount
              value: "0"

          - delay: 1s
          - component.update: mqx_raw
          #- component.update: particulate_matter
          - delay: 1s
          - component.update: mqx_raw
          #- component.update: particulate_matter
          - delay: 1s
          - component.update: mqx_raw
          #- component.update: particulate_matter
          - delay: 500ms
          - switch.turn_off: switch_reducer
          - switch.turn_off: measure_sps30
          - logger.log: 
              format: "AUTO MEASURE MQx/Radiation COMPLETE"
              level: warn
    entity_category: config

#-------------------------------------------
# Manual update component
#-------------------------------------------
  - platform: template
    name: "GEIGER MQ - Update"
    icon: mdi:air-filter
    turn_on_action:
      - then:
          #- component.update: adcuv
          - component.update: mqx_raw
          #- component.update: particulate_matter
          - delay: 1s
          - component.update: mqx_raw
          #- component.update: particulate_matter
          # EDIT
          - component.update: geigercount

          - delay: 1s
          - component.update: mqx_raw
          #- component.update: particulate_matter
          - delay: 1s
          - component.update: mqx_raw
          #- component.update: particulate_matter
          - delay: 1s
          - component.update: mqx_raw
          #- component.update: particulate_matter
          - logger.log: 
              format: "MANUAL MEASURE mqx/radiation COMPLETE"
              level: warn
    entity_category: config

#-------------------------------------------
# BUTTONS
#-------------------------------------------
button:
#-------------------------------------------
# Deep Sleep Enable button
#-------------------------------------------
  - platform: template
    name: "DeepSleep - Enter"
    icon: mdi:power-sleep

    entity_category: config
    on_press:
      then:
        - deep_sleep.enter: sleep_component
          
#-------------------------------------------
# button template: Clean sensor SPS30
#-------------------------------------------
  - platform: template
    name: "PM - Clean"
    entity_category: config
    icon: mdi:fan
    #id: switch_measure_sensors
    on_press:
      then:
        - sps30.start_fan_autoclean: my_sps30  

#-------------------------------------------
# Deep Sleep button
#-------------------------------------------
  - platform: template
    name: "DeepSleep - Disable"
    icon: mdi:power-sleep
    id: deepsleep_switch
    entity_category: config
    on_press:
      then:
        - binary_sensor.template.publish:
            id: sleep_prevent
            state: True
        - script.stop: sleep_script
        - logger.log: 
            format: "SWITCH PREVENT DEEPSLEEP"
            level: warn
        - deep_sleep.prevent: sleep_component

#--------------------------------------------
# MHZ Calibrate zero point
# Calibrate after 20min in static indoor air 
#--------------------------------------------
  - platform: template
    name: "MHZ-19 - Calibrate Zero"
    on_press:
      then:
        - mhz19.calibrate_zero: mhz19_co2
    entity_category: config

#-------------------------------------------
# RESTART
#-------------------------------------------
  - platform: restart
    name: "Restart"

#-------------------------------------------
# INTERVALS - Reducer measurement cycling
#-------------------------------------------
interval:
  # reducer conumption switch repeat measure
  - interval: 15min
    then:
      - switch.turn_on: switch_reducer

  # rain drop sensor repeat measure
  - interval: $measure_wet
    then:
      if:
        condition:
          sensor.in_range:
            id: rain_res
            below: 49.990
        then:
          - switch.turn_on: res_bias
          - logger.log: 
              format: "WET MEASURE TIME"
              level: warn
  - interval: $measure_dry
    then:
      if:
        condition:
          sensor.in_range:
            id: rain_res
            above: 49.990
        then:
          - switch.turn_on: res_bias
          - logger.log: 
              format: "DRY MEASURE TIME"
              level: warn

#-------------------------------------------
# TIME COMPONENT
#-------------------------------------------
time:
  - platform: sntp
    id: esptime
    timezone: "Europe/Bratislava"

#-------------------------------------------
# OUTPUTS
#-------------------------------------------
output:
#-------------------------------------------
# RadiationShield Fan 5V
# control whit PWM NPN Darlington TIP122
#-------------------------------------------
  - platform: ledc
    pin: "$fan_pwm_pin"
    frequency: 20000 Hz
    id: fan_pwm
    #min_power: 0.0 # min power 70mA power consumption
    #max_power: 0.80 # max power 150mA power consumption
    max_power: 0.90 


#  - id: spotlight_output
#    platform: gpio
#    pin: "$spotlight"

fan:
  - platform: speed
    output: fan_pwm
    name: "Fan"
    id: shield_fan

#-------------------------------------------
# Spotlight - white 8x white led 3.3V
#-------------------------------------------
light:
#  - platform: binary
#    name: "${friendly_name} Led White"
#    output: spotlight_output
#    icon: mdi:spotlight-beam
